naidol/jupitercpp_ws/docs/ESP32_S3_MCU_JUPITER_PINOUT.md

# ESP32-S3 MCU — Jupiter Pinout  ·  ⚠ MOVED

**This file is a stub. Do not edit it, and do not use it as a reference.**

The pin map was absorbed into **`NEW_MOTION_CONTROL_BOARD_2026.md` §3.1** on **2026-08-24**, which
is now the single source of truth for the 2026 board redesign — pin map, BNO086 breakout wiring,
power rails, connectors and BOM.

Two documents carrying the same pin map is exactly how they drifted apart: this file and §3.1
disagreed about GPIO4, GPIO9, the INA226 and the I²C bus for three days before it was caught.

**Go to:** [`NEW_MOTION_CONTROL_BOARD_2026.md`](NEW_MOTION_CONTROL_BOARD_2026.md) → §3.1

The full pre-merge content is preserved in git history (`git log --follow -- docs/ESP32_S3_MCU_JUPITER_PINOUT.md`).
