naidol/jupitercpp_ws/apriltags/tag36h11_id1_100mm_A4.pdf

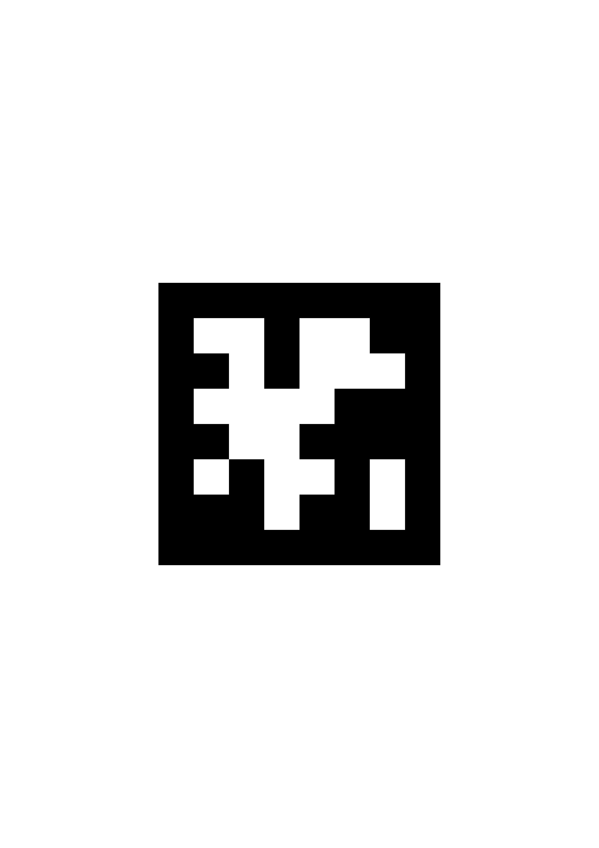
[picture p1: page 1]
