naidol/jupitercpp_ws/apriltags/tag36h11_id1_80mm_A4.pdf

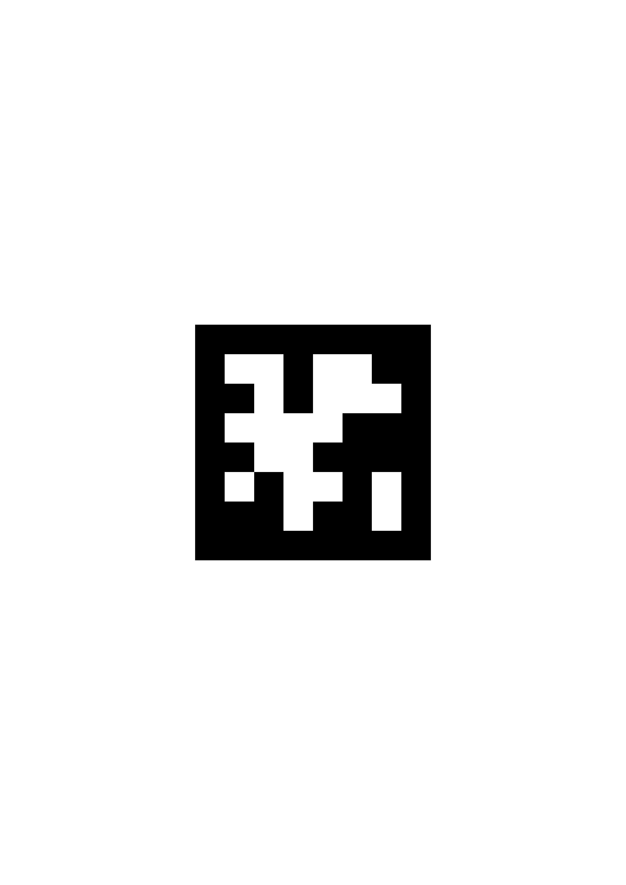
[picture p2: page 1]
