naidol/jupitercpp_ws/apriltags/tag36h11_id1_60mm_A4.pdf

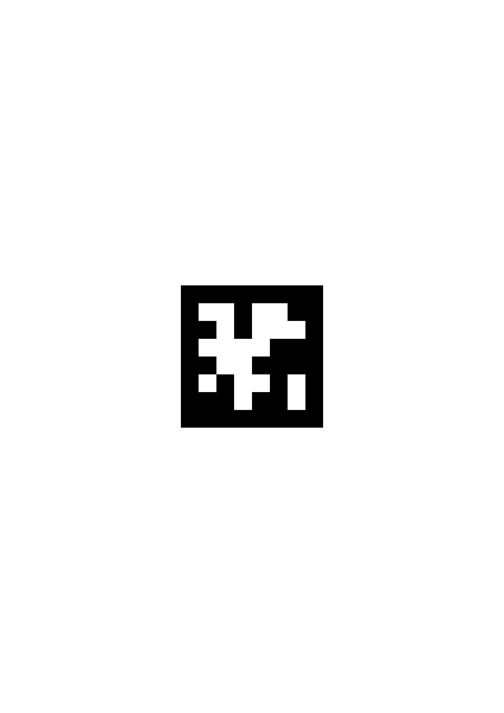
[picture p3: page 1]
