naidol/jupitercpp_ws/apriltags/tag36h11_id2_A4.png

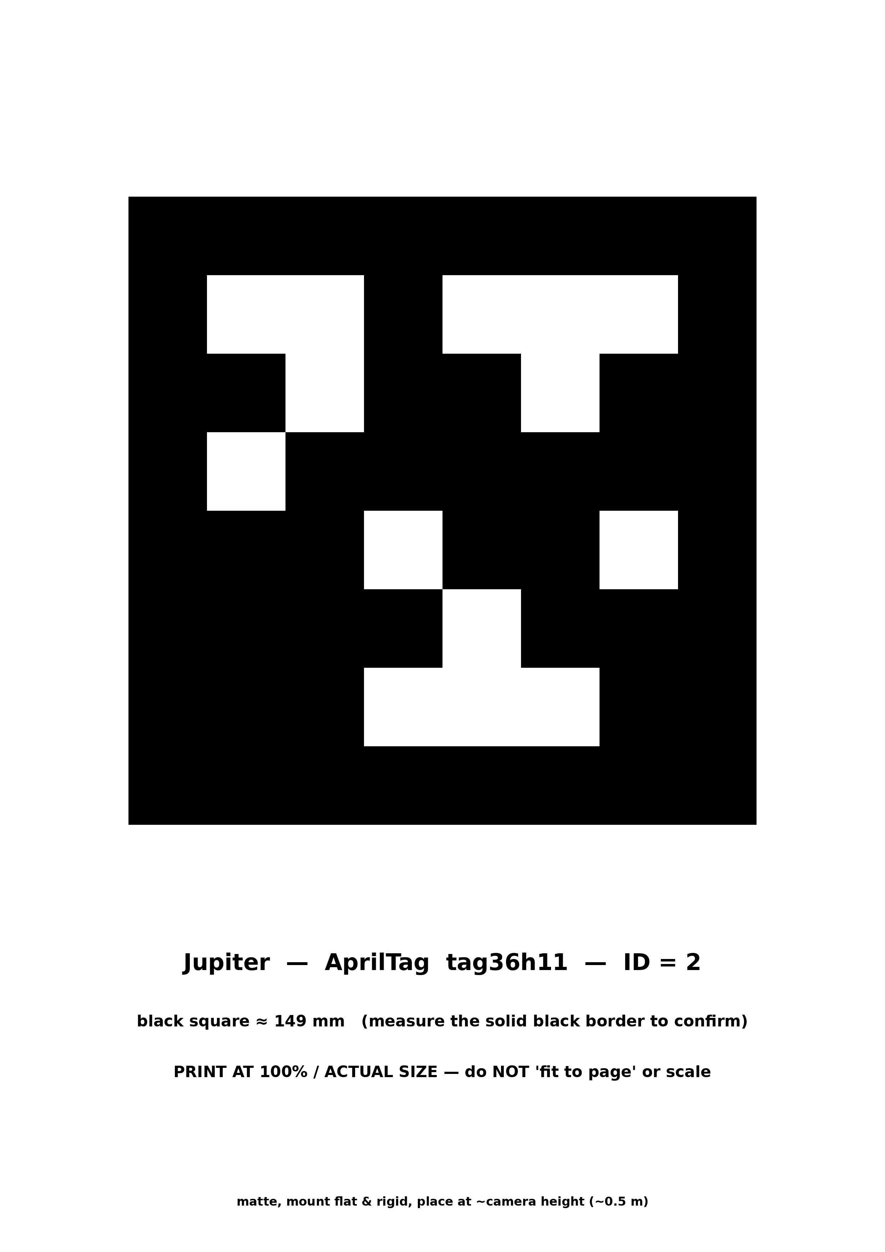
apriltags/tag36h11_id2_A4.png
