naidol/jupitercpp_ws/maps/_compare3.png

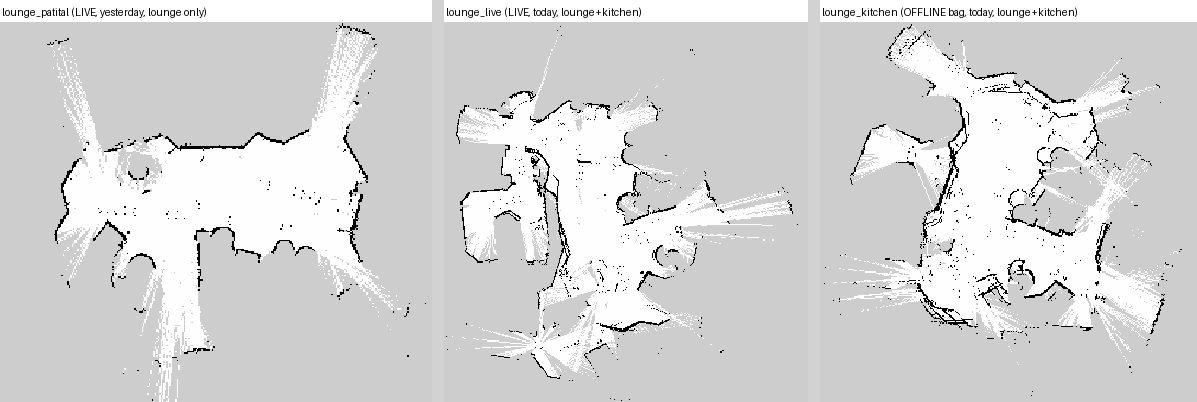
maps/_compare3.png
