naidol/jupitercpp_ws/maps/_deskew_compare.png

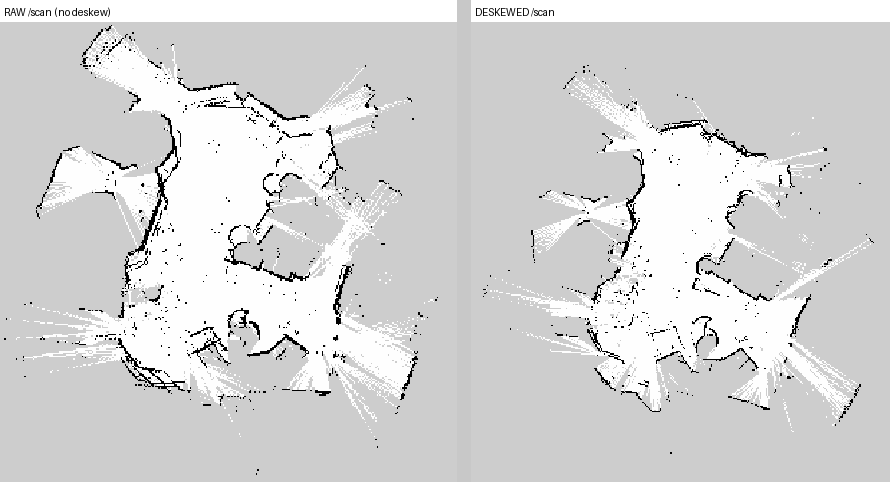
maps/_deskew_compare.png
