naidol/jupitercpp_ws/maps/apartment_s2e_v2_view.png

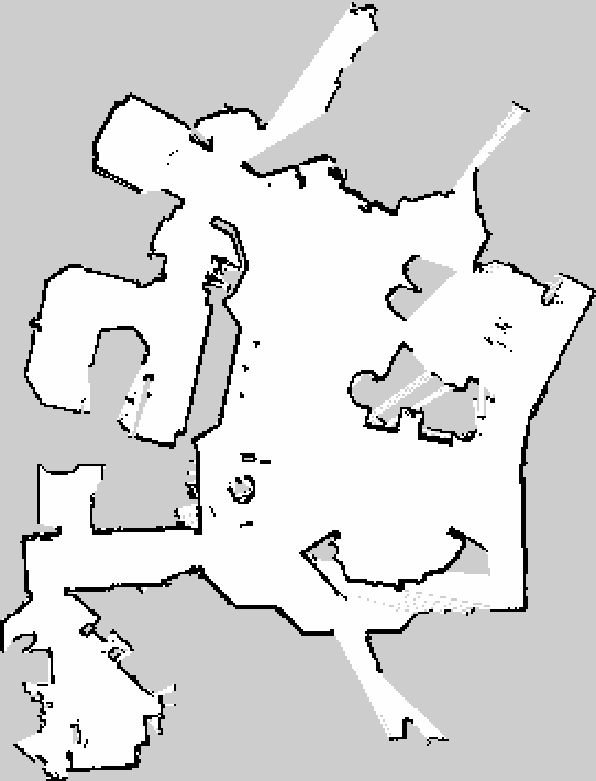
maps/apartment_s2e_v2_view.png
