naidol/jupitercpp_ws/maps/apartment_s2e_view.png

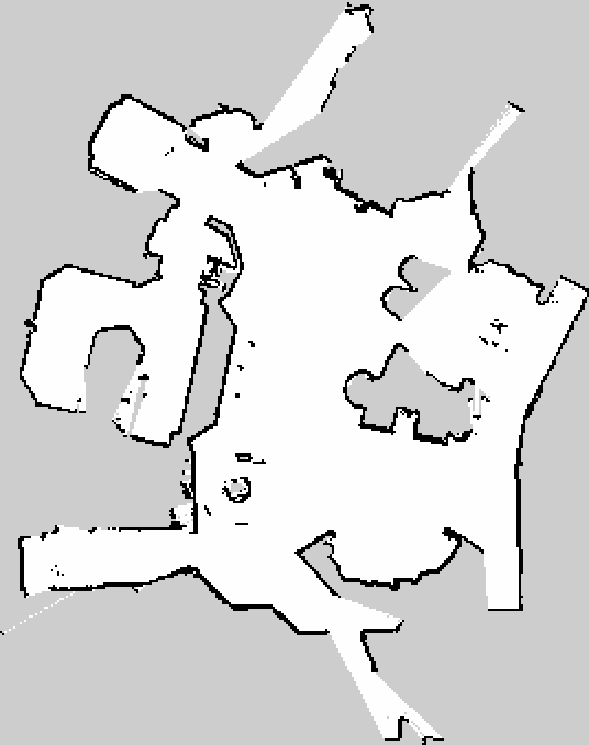
maps/apartment_s2e_view.png
