naidol/jupitercpp_ws/maps/apartment_view.png

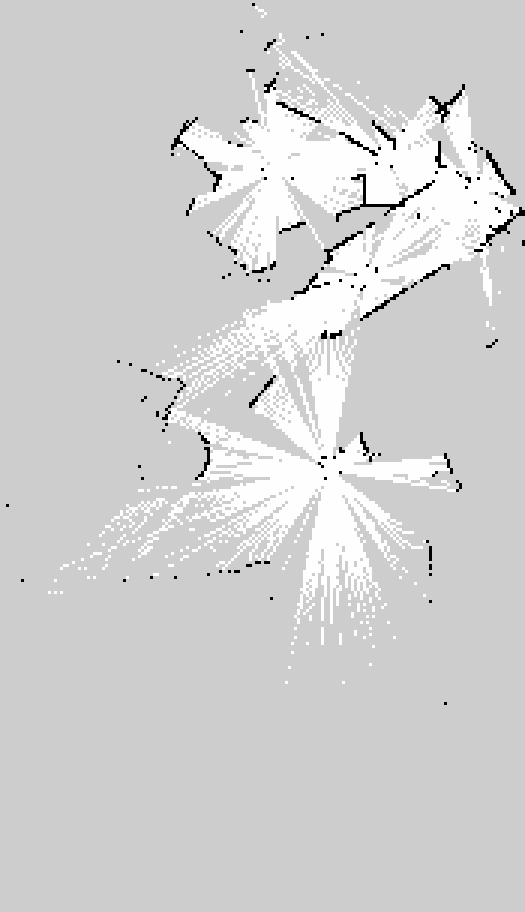
maps/apartment_view.png
