naidol/jupitercpp_ws/maps/lounge_kitchen_view.png

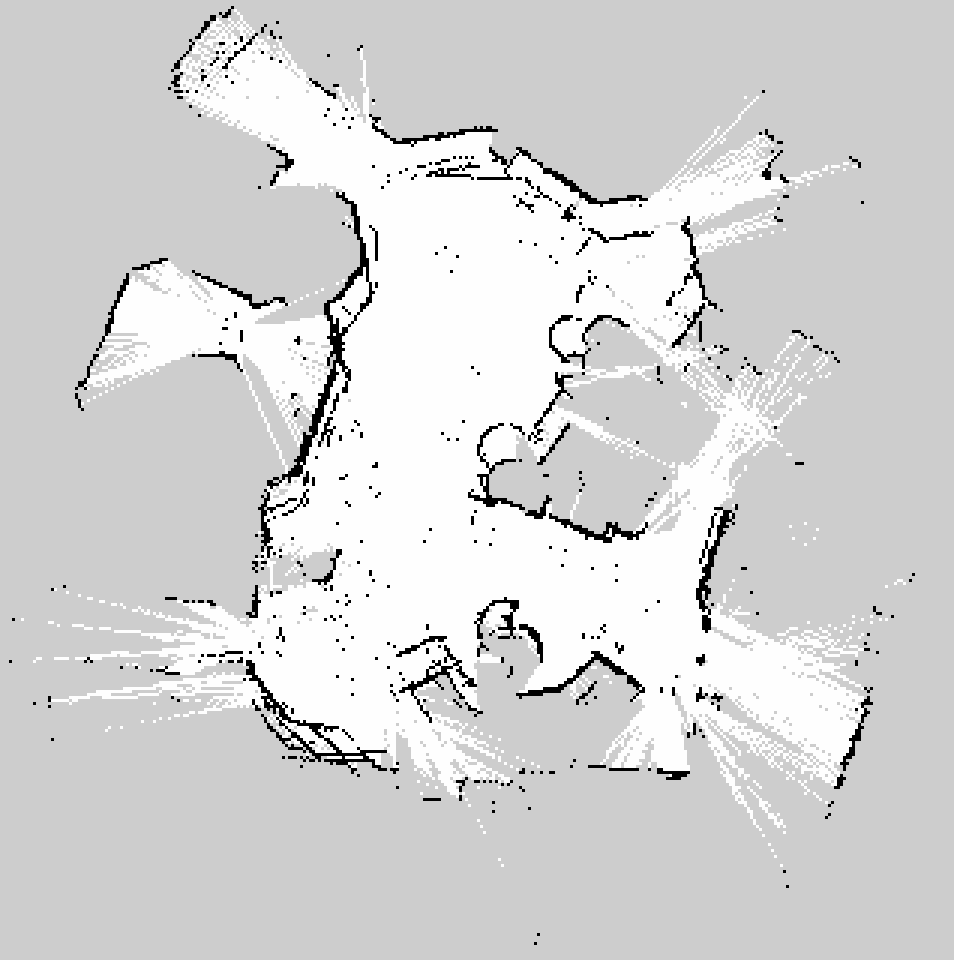
maps/lounge_kitchen_view.png
