naidol/jupitercpp_ws/maps/lounge_live_view.png

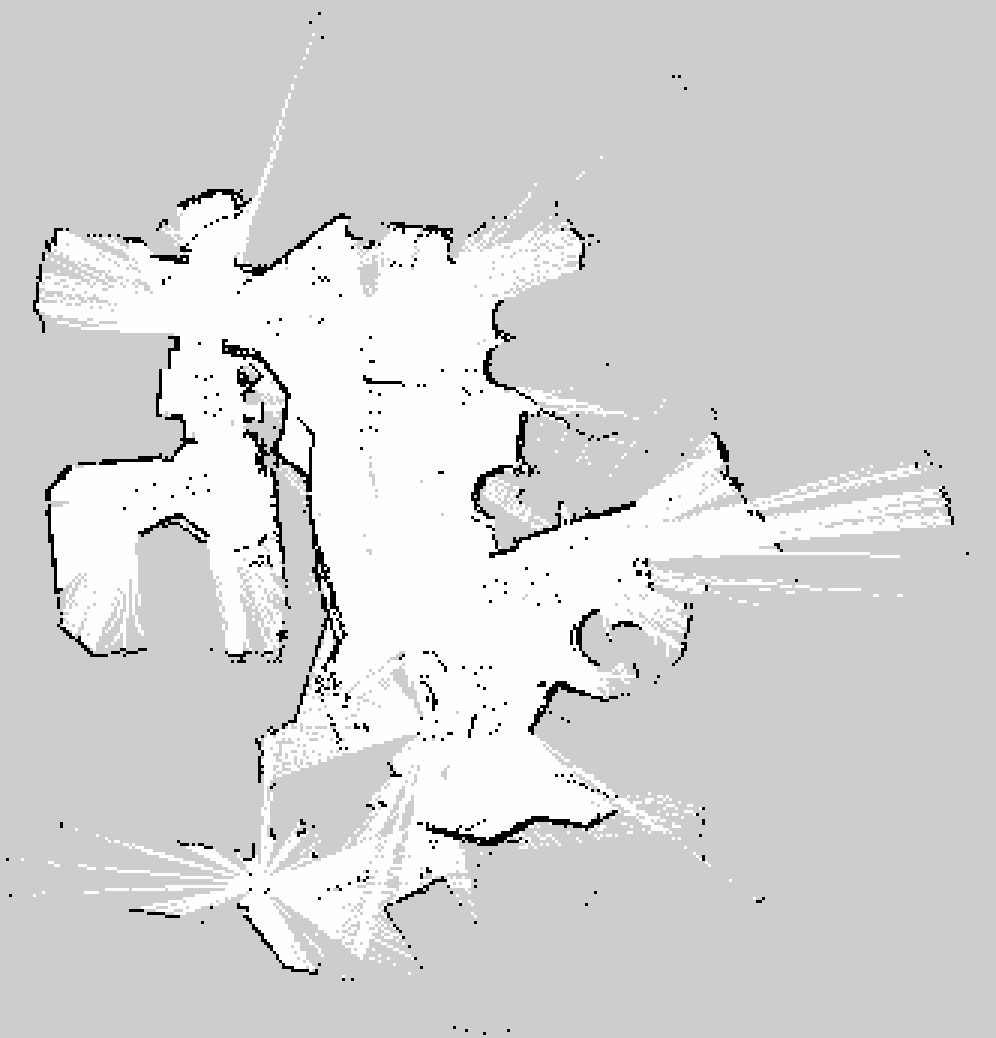
maps/lounge_live_view.png
