naidol/jupitercpp_ws/maps/lounge_patital_view.png

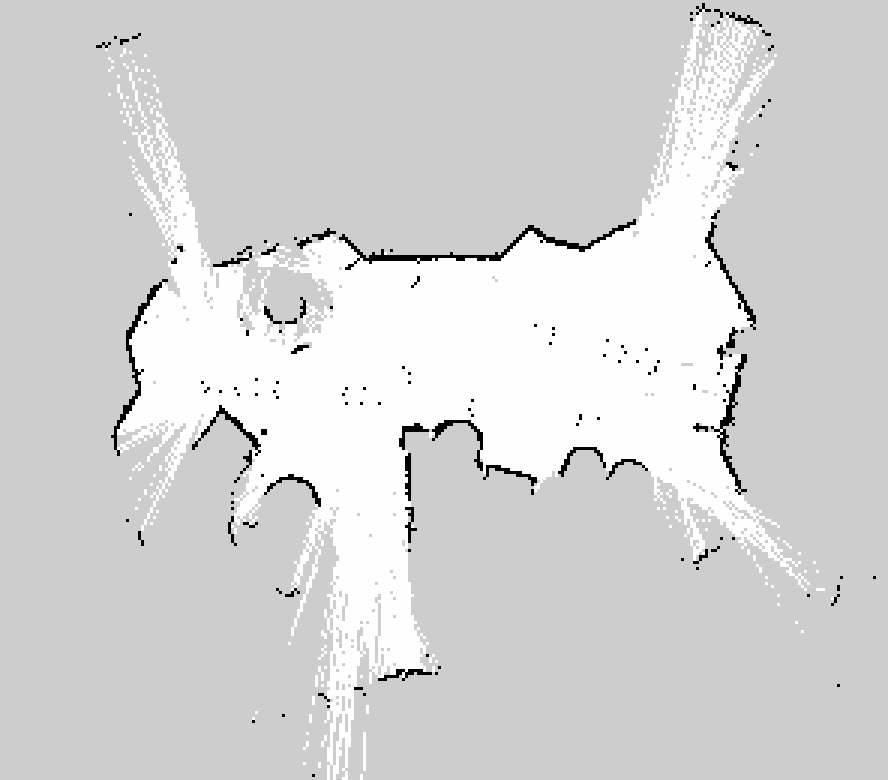
maps/lounge_patital_view.png
