naidol/jupitercpp_ws/hardware/dock_funnel/funnel_rail_left.stl

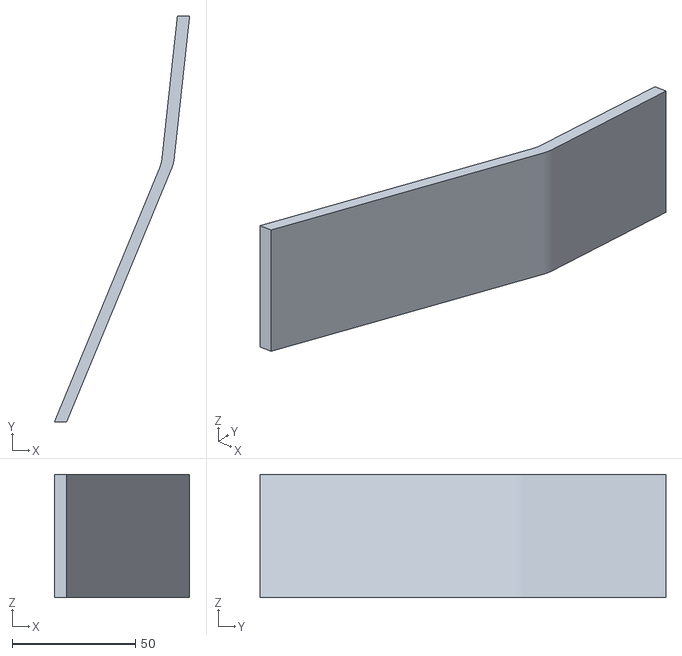
[picture p18: CAD file, 2026-08-01]
hardware/dock_funnel/funnel_rail_left.stl
55.0 x 165.0 x 50.0
