naidol/jupitercpp_ws/(list of files, cad)

Other CAD files:
hardware/dock_funnel/funnel_rail_profile.dxf
hardware/dock_funnel/funnel_rail_right.stl
