naidol/jupitercpp_ws/(commit log)

2026-05-04 Initial commit — Jupiter ROS2 workspace
    Packages:
    - jupiter_bringup: localization (EKF + BNO055), SLAM, Nav2 launch files and config
    - jupiter_nodes: imu_covariance_fixer, diagnostics, vision stubs
    - ldlidar_stl_ros2: LD19 driver (modified ld19.launch.py for Jupiter — base_footprint TF, /dev/jupiter_lidar port)
2026-05-05 Add master jupiter_bringup.launch.py
    Single launch entry point for the full robot stack:
    - micro-ROS agent (t=0s)
    - localization + SLAM or Nav2 (t=3s, mode:=slam default or mode:=nav)
    - LD19 LiDAR (t=6s, after TF tree is ready to avoid scan timestamp race)
    Voice and vision nodes stubbed as comments for future integration.
2026-05-05 Tune LiDAR range params for LD20 (8m indoor, 6Hz)
    slam_params: max_laser_range 12.0 -> 7.5m
    nav2_params: amcl laser_max_range 100.0 -> 8.0m
2026-05-05 Add CLAUDE.md with full project spec and current status
    Renamed from claude.md so Claude Code auto-loads it each session.
    Updated package structure, completed subsystems, and known issues
    to reflect current state of the build.
2026-05-06 Add jupiter_voice and jupiter_brain C++ ROS2 nodes
    - voice.cpp: ALSA capture (ReSpeaker plughw:2,0) → whisper.cpp GPU ASR
    → /voice/raw_text; /voice/response_text → piper TTS → speaker
    Handles USB full-duplex by closing/reopening ALSA handle around TTS;
    is_speaking_ flag blocks re-transcription during brain processing.
    - brain.cpp: /voice/raw_text → Ollama HTTP (gemma4:e2b, 100% GPU)
    → /voice/response_text; rolling 6-turn conversation history;
    current date/time injected per query; emoji stripped for clean TTS;
    handles thinking-model empty content field gracefully.
    - CMakeLists.txt: adds jupiter_voice (asound + whisper.cpp) and
    jupiter_brain (libcurl + nlohmann_json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
2026-05-06 Add face recognition, VLM vision, and per-user memory to Jupiter
    - face_recognition.cpp: YuNet (OpenCV CPU) + SFace (TensorRT CUDA) face
    recognition; profiles stored as JSON embeddings in memory/profiles/;
    publishes /current_user at 1Hz; supports /vision/register and /vision/trigger
    - brain.cpp: visual intent detection routes to llava:7b VLM with base64 JPEG;
    text queries use gemma4:e2b; per-user conversation history persisted to
    memory/conversations/<Name>.json; guest registration flow; user-aware greetings
    - CMakeLists.txt: add TensorRT (nvinfer, nvonnxparser), CUDA runtime, and
    nlohmann_json linkage for jupiter_face_recognition
    - jupiter_bringup.launch.py: add camera, voice, bra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
2026-05-07 Fix audio capture and face recognition guest detection
    - Replace ALSA capture with pw-record via fork/exec — PipeWire owns the
    ReSpeaker hardware after reboot making direct ALSA access unreliable;
    pw-record uses PipeWire natively matching pw-cat used for TTS playback
    - Remove asound library dependency from CMakeLists
    - Add clean Ctrl+C shutdown: destructor kills pw-record child PID before
    joining audio thread so exit is immediate rather than blocking 5s
    - Add response watchdog (30s) so voice node never gets permanently stuck
    if brain goes silent; deadline initialised to max() to prevent spurious
    firing on brain-initiated greetings
    - Lower energy_threshold to 300 (noise floor ~45,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
    [face_recognition.cpp, voice.cpp]
2026-05-08 Filter Whisper noise labels and raise SLAM bond timeout
    - Drop ASR results that are Whisper noise labels ([Barking], [Music],
    (applause), *beep* etc.) before publishing to brain — prevents ambient
    sounds like vacuum cleaners or fans from triggering LLM responses
    - Raise lifecycle_manager bond_timeout from 4s to 15s in slam.launch.py
    so SLAM toolbox has enough time to initialise under heavy GPU startup
    load (Whisper + TRT SFace + camera all loading simultaneously)
    [voice.cpp]
2026-05-09 Tune SLAM/voice load and add AI-only launch mode
    - Add enable_slam flag (default false) — voice/vision/brain/camera run
    without SLAM/LiDAR; enable_slam:=true brings up full navigation stack
    - Two camera configs: color-only MJPG in AI-only mode (avoids USB DMA
    contention with Whisper), color+depth in SLAM mode for Nav2 costmaps
    - slam_toolbox: minimum_time_interval 0.5→1.0 to halve Ceres CPU load
    - lifecycle_manager: bond_timeout 0.0 disables false bond-failure errors
    caused by Ceres initialization blocking heartbeats
    - Voice: energy_threshold 300→500 to filter ambient noise; record_seconds
    5→8 to reduce Whisper GPU inference frequency during SLAM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
2026-05-12 Update CLAUDE.md with completed firmware subsystems
    - ESP32 auto-reconnect state machine complete
    - ESP32 battery monitoring firmware complete (hardware wiring pending)
    - Remove resolved known issue (physical reset no longer needed)
2026-05-13 Reduce Whisper hallucinations with three filters
    1. no_speech_prob check: skip segments where Whisper's own no-speech
    probability exceeds 0.5 — catches ambient noise Whisper classifies
    as non-speech internally but still transcribes
    2. Minimum 2-word filter: single-word results (e.g. "you") are almost
    always hallucinations from background noise
    3. 500ms post-TTS silence buffer: prevents room echo from TTS playback
    being captured at the start of the next recording window
    [voice.cpp]
2026-05-13 Fix Whisper hallucination: remove robot prompt + add token confidence check
    The initial_prompt 'Jupiter is a home robot assistant' primed Whisper to
    generate robot/computer vocabulary from ambient noise (HVAC/fan hum),
    causing the same on-topic hallucination to repeat across sessions.
    Average token confidence < 0.40 now rejects the result — hallucinated text
    from background noise has characteristically lower token probabilities than
    genuine speech. Combined with the existing no_speech_prob and word-count
    filters, this should eliminate the repeating false transcriptions.
    [voice.cpp]
2026-05-16 Add temporal energy ratio VAD to eliminate Whisper GPU jitter
    Replace sherpa-onnx (ONNX Runtime CUDA conflict) with a zero-dependency
    VAD: splits each 8s capture into 100ms windows and skips Whisper when
    max/min RMS ratio < vad_snr_ratio (default 1.7). HVAC noise ratio ~1.1,
    speech ratio ~2-10. Also makes micro-ROS agent optional via
    enable_microros launch arg (default false).
    [voice.cpp]
2026-05-18 Add Jupiter Display node — Qt6 QML animated robot face on 7-inch panel
    - New package: jupiter_display (Qt6 + ROS2, pure C++)
    - DisplayBridge QObject exposes state/currentUser/batteryVoltage/speakingMs to QML
    - Subscribes: /current_user, /voice/raw_text, /voice/response_text, /battery/state
    - States: LISTENING (smile), PROCESSING (squint + dots), SPEAKING (open mouth animation)
    - C++ screen selection targets 1024x600 panel (DP-1); falls back to primary
    - Qt event loop exits cleanly on Ctrl+C via 200ms rclcpp::ok() poll timer
    - Added jupiter_display to bringup launch (2s delay, DISPLAY=:1)
2026-05-19 Fix brain LLM blocking spin thread and voice watchdog too short
    - brain: move LLM/VLM calls to background thread — spin loop stays
    responsive during Ollama inference; llm_busy_ atomic prevents
    overlapping requests
    - brain: max_tokens 2000 → 400 — 1-3 sentence responses don't need
    2000 tokens; cuts gemma4 response time from 45s to ~10s
    - brain: null-safe content extraction in http_post() — was throwing
    json::type_error when content field is null
    - voice: response_timeout_s default 30 → 90 — 30s fired before the
    LLM had time to respond, silently dropping every text answer
    [brain.cpp, voice.cpp]
2026-05-19 Fix spurious watchdog and LLM identity override by voice
    - voice: reset speak_deadline_ to max() after each TTS response —
    stale deadline from a prior query was causing the watchdog to fire
    3-4s into the next autonomous greeting (face recognition transition)
    - brain: instruct LLM that face recognition is the authoritative
    identity; prevents a voice claim of "I'm Indrani" from overriding
    face-confirmed "Logan", which was corrupting Logan's history file
    with another person's conversation
    [brain.cpp, voice.cpp]
2026-05-19 Fix VLM identity bridge, stale snapshot, VAD stuck loop, and clean shutdown
    brain.cpp:
    - Pass captured_user at query time to query_vlm/query_llm to avoid race
    where face recognition briefly returns Unknown during slow llava inference
    - Delete /tmp/jupiter_view.jpg before triggering snapshot and poll for fresh
    file (up to 2s) to prevent stale frames from previous sessions being used
    - Add gemma4:e2b identity bridge in query_vlm: llava:7b describes the scene,
    gemma4:e2b synthesises a one-sentence reply using the C++ face engine identity
    - Instruction-first bridge prompt layout so the 2B model follows format rules
    - Name-injection fallback: prepend "for_user, " if name absent from respons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
    [brain.cpp, face_recognition.cpp, voice.cpp]
2026-05-20 Fix Ctrl+C SIGKILL regression in voice and display nodes
    jupiter_voice: blocking waitpid() in capture_chunk() and speak() shutdown
    paths caused the audio thread to hang indefinitely after SIGINT. Linux
    SA_RESTART (set by rclcpp's signal handler) causes interrupted syscalls to
    restart automatically, so a blocking waitpid() after SIGTERM never returned.
    Fix: use SIGKILL in the shutdown path so waitpid() returns in microseconds.
    The normal end-of-chunk deadline path uses a WNOHANG poll loop instead.
    jupiter_display: ros_thread was detached, allowing it to outlive main()'s
    return and use rclcpp/DDS objects after their destructors fired — causing a
    hang during process cleanup. Fix: capture n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
    [voice.cpp]
2026-05-20 Add system status HUD to display and fix micro-ROS launch delay
    Display node now subscribes to /camera/color/camera_info, /scan, and
    /cmd_vel to track sensor health, and polls sysfs every 2s for CPU/GPU
    temperatures and WiFi signal strength.
    JupiterFace.qml gains a top bar (mode indicator + velocity + WiFi %)
    and an expanded bottom bar with CAM/LIDAR/VOICE health dots, CPU/GPU
    temperature readouts, and a visual battery bar with % and voltage.
    Sensor dots blink red when offline; temps colour-shift orange >70°C
    and red >85°C; battery bar colours by charge level.
    micro-ROS agent launch delay reduced from 70s to 10s now that the
    ESP32 serial adapter is on USB-C Bus 001, fully isolated from O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
2026-05-20 Ignore sherpa-onnx binaries and model archives
    sherpa-onnx/ and sherpa-onnx-kws-zipformer-gigaspeech-3.3M-2024-01-01/
    are downloaded prebuilt binaries and ONNX models — too large for git
    and not source code. Added matching .tar.bz2 glob as well.
2026-05-20 Fix SPEAKING→LISTENING lag with exact TTS-done signal
    Replace the word-count timer estimate in the display node with a
    precise /voice/tts_done (std_msgs/Empty) signal published by the
    voice node immediately after TTS playback finishes and the 500ms
    room-echo pause elapses.
    Display now transitions from SPEAKING to LISTENING at the exact
    moment audio stops rather than after a ~1s overestimate. Removes
    speakingMs property and QML Timer entirely — no estimate needed.
    [voice.cpp]
2026-05-21 Add LiDAR watchdog to auto-recover from Whisper-induced frame sync loss
    Whisper GPU inference causes tegra-xusb DMA stalls that overflow the LD19
    cp210x serial FIFO, breaking SDK frame sync. The ldlidar SDK has no built-in
    recovery — once frame sync is lost, it emits timeout errors indefinitely.
    The watchdog (lidar_watchdog.sh) monitors /scan and restarts
    ldlidar_stl_ros2_node within ~10s of detecting a timeout. The static TF
    publisher (base_footprint→base_laser) is split out to run independently so
    the transform is never interrupted during LiDAR restarts.
    Also carries forward: depth disabled in SLAM camera config (90s→38s init),
    LiDAR delayed to 30s (was 6s), micro-ROS agent kept at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
2026-05-21 Reduce micro-ROS startup delay from 70s to 15s
    Camera now initialises in ~3s after ReSpeaker was isolated onto a
    separate hub branch, so the original 70s (set when camera took ~38s)
    is no longer needed. 15s gives comfortable margin after camera (~7s)
    and AI nodes (~10s) are fully settled.
2026-05-21 Fix conversation history reset on bringup restart
    Non-atomic writes to the JSON history file were being corrupted by
    Ctrl+C landing between file truncation and write completion, causing
    json::parse to throw on next load and silently clear history.
    Fixed with atomic write-then-rename (rename(2) is a single kernel
    syscall). Also added an explicit save in the destructor so clean
    shutdown always flushes the last exchange before exit.
    [brain.cpp]
2026-05-21 Add sleep face to display and fix wake-on-face-detect bug
    Brain publishes /jupiter/sleeping (std_msgs/Bool) on sleep/wake.
    Display subscribes and drives three visual changes:
    - Eyes close slowly to a thin slit (yScale 0.06) over 800ms
    - Mouth shows a flat neutral line instead of a smile
    - Status bar shows 'SLEEPING' in dim colour
    Also fixes user_callback triggering greet_user while sleeping —
    face re-detection in sleep mode now silently updates user tracking
    without speaking.
    [brain.cpp]
2026-05-21 Fix guest name extraction and registration flow bugs
    - extract_name() strips natural-speech preambles ("my name is", "I am",
    etc.) so any conversational reply yields the correct first name
    - Word-boundary check on "no" prevents false declines from words like
    "know", "noel", or "normal"
    - Set current_user_ before speaking "Done!" to prevent user_callback
    double-greeting on the next 1Hz face-recognition tick
    [brain.cpp]
2026-05-22 Fix sleep/wake stuck bug and tune VAD for ReSpeaker
    - brain.cpp: publish empty ack when sleeping and input is not a wake
    phrase, so voice.cpp clears is_speaking_ immediately instead of
    waiting out the 90s response timeout
    - voice.cpp: response_callback clears is_speaking_ on empty response
    (silent ack) rather than returning without resetting state
    - bringup: lower energy_threshold 500→300 for ReSpeaker with on-chip
    noise suppression (silence RMS ~12, well below 300)
    - face_recognition: add per-match similarity logging to aid threshold
    tuning; Guest logs closest-miss score
    - display_node: hide window before app.quit() on shutdown (partial fix,
    parked — framebuffer still retain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
    [brain.cpp, face_recognition.cpp, voice.cpp]
2026-05-25 Fix SLAM: resolve heading misalignment, odom drift, and starburst
    Three root causes diagnosed and fixed:
    1. imu0_differential: true — BNO055 reports absolute yaw relative to
    magnetic north, not robot forward direction. With differential=false,
    the odom/map frames started 90° off from the robot's physical heading,
    placing every scan node at the wrong orientation and making scan
    matching fail. Using yaw changes instead of absolute yaw fixes alignment.
    2. odom0_relative: true — ESP32 odometry counters accumulate across
    micro-ROS reconnects without resetting. Each new ROS session inherited
    the previous session's accumulated position, displacing the map origin.
    Relativ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
2026-05-25 Enable camera during SLAM mapping for remote RViz visual feedback
    Camera was gated behind enable_voice, but the DMA stall issue was caused
    by Whisper GPU inference, not the camera stream. Color-only MJPG 640x480
    @ 15fps is low USB bandwidth and does not affect LiDAR serial throughput.
    Decoupling camera from voice lets the operator see a live image feed in
    RViz2 while manually mapping, reducing collision risk during remote teleop
    over WiFi without relying on laser scan alone.
2026-05-25 Replace AMCL+EKF with Isaac ROS cuVSLAM for navigation localisation
    Install Isaac ROS 4.4.0 native apt packages (no Docker): cuVSLAM,
    occupancy_grid_localizer, AprilTag, nvblox core. cuVSLAM publishes
    the full map→odom→base_footprint TF chain from Orbbec 336 depth+IMU,
    eliminating AMCL drift and EKF dead-reckoning dependency.
    - visual_slam.launch.py: cuVSLAM node (RGBD+IMU mode), camera TF
    base_footprint→camera_link at (0.10, 0.0, 0.49m)
    - navigation.launch.py: remove AMCL+EKF, include visual_slam launch
    - jupiter_bringup.launch.py: split slam/nav camera modes; nav mode
    enables depth 640×480@30fps + accel/gyro 200hz sync output
    - nav2_params.yaml: odom_topic → /visual_slam/trac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
2026-05-25 Fix cuVSLAM: IMU fusion, correct topics, jitter threshold; add maps and new packages
    cuVSLAM fixes (confirmed working — map→odom→base_footprint at 28 Hz):
    - Raise image_jitter_threshold_ms 40→100ms: Orbbec delivers at ~66ms/15fps,
    40ms threshold caused cuVSLAM to reject every frame and never publish odom TF
    - Fix imu_frame: camera_gyro_optical_frame → camera_accel_gyro_optical_frame
    (confirmed from live topic echo of /camera/gyro_accel/sample)
    - Fix depth remapping: /camera/depth_to_color/image_raw → /camera/depth/image_raw
    (Orbbec SDK 2.7.6 with align_mode=SW publishes on depth, not depth_to_color)
    - Fix IMU remapping: /camera/imu → /camera/gyro_accel/sample
    - Explicitly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
2026-05-25 Replace LiDAR with vision-only nav: cuVSLAM + nvblox + Nav2 MPPI
    - Remove LiDAR entirely (LD19 static TF, watchdog script, all LiDAR
    costmap layers) — tegra-xusb DMA contention made it unworkable
    - Add nvblox.launch.py: GPU TSDF reconstruction from Orbbec depth
    → 2D ESDF slice for Nav2 NvbloxCostmapLayer
    - Rewrite navigation.launch.py: map_server removed, nvblox added,
    cuVSLAM provides localisation (no pre-built map required)
    - Rewrite slam.launch.py: pure cuVSLAM visual-map-building mode,
    slam_toolbox and EKF removed
    - nav2_params.yaml: replace all LaserScan/VoxelLayer config with
    NvbloxCostmapLayer; add global costmap bounds (40x40m);
    add transform_tolerance:0.5 for cuVSLAM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
2026-05-27 Fix vision-only nav: passive IR stereo, safe mecanum recovery, confirmed 3m nav
    - cuVSLAM: switch to passive IR stereo (projector OFF) — projector dot pattern
    moves with camera and causes tracking drift; ambient IR tracks room-fixed features
    - cuVSLAM: correct optical frame IDs to camera_left/right_ir_optical_frame
    - cuVSLAM: camera pitch 0 (level) — upward tilt reduces wall features in FOV
    - Nav2: remove Spin+BackUp recovery behaviors — unsafe on mecanum (caused bar stool
    collision); replace with costmap clear + Wait in custom BT XMLs
    - Nav2: add navigate_to_pose_omni.xml and navigate_through_poses_omni.xml
    - Nav2: add decay_time to ObstacleLayer to prevent goal cell burial in sta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
    [brain.cpp]
2026-05-29 Fix nav stack: LiDAR yaw, lifecycle timeout, inflation tuning
    - Revert base_laser yaw to 0 (LiDAR physically rotated back to correct orientation)
    - Disable cuVSLAM map→odom; replace with static identity TF (bad VIO transform
    was lifting costmaps off floor and corrupting base_footprint orientation)
    - Delay lifecycle_manager 5s + bond_timeout=0 to fix MPPI CUDA init timeout
    that left planner_server and bt_navigator unconfigured at startup
    - Increase inflation_radius 0.20→0.30 in both costmaps and MPPI ObstaclesCritic
    - Increase ObstaclesCritic repulsion_weight 1.0→3.0, critical_weight 10.0→20.0,
    collision_margin_distance 0.10→0.15 for better wall avoidance in narrow passage
    - N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
2026-05-29 Add jupiter_bringup_full.launch.py — unified full-stack launch
    Single Orbbec camera instance serving all subsystems simultaneously:
    - Left/Right IR stereo @ 15fps for cuVSLAM
    - Color MJPG 640x480 @ 15fps for face recognition
    - IMU 200Hz for EKF
    - Laser projector OFF (mandatory for passive IR cuVSLAM tracking)
    - Depth disabled (saves DMA bandwidth)
    Fixes camera conflict where nav-only and voice-only bringups both
    tried to open the Orbbec independently, causing uvc_open -6 errors
    and system slowdown/reboot.
    Startup sequence timed to avoid USB DMA contention:
    t=0s display, t=2s micro-ROS, t=3s nav stack,
    t=5s camera, t=7s voice+brain, t=8s face recog+vision
    Usage: ros2 launch jupiter_bring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
2026-05-29 Fix full bringup: add LaunchConfiguration import, reduce color fps
    - Add missing LaunchConfiguration import (caused launch error)
    - Reduce color stream from 15fps to 6fps to prevent LiDAR USB DMA
    starvation — IR stereo + color + IMU at 15fps saturated tegra-xusb
    causing LD20 serial timeout errors
2026-05-30 Fix full bringup: add LaunchConfiguration import, reduce color fps
    - Redesign bringup startup sequence for blitsvinnig AI-only mode:
    t=0s display + screensaver/DPMS disabled
    t=1s camera (color+depth+IMU) — depth required to avoid 20s SDK timeout
    t=2s voice/Whisper — ready before first face match to avoid greeting race
    t=3s face recognition, vision, brain
    - Fix Orbbec SDK 20s color-only timeout: enable depth 424x240@6fps as dummy
    stream (nobody subscribes) — forces fast SDK init path (~235ms vs 22s)
    - Fix greeting race condition: Voice was starting at t=8s, brain published
    greeting at t=5s, display stuck on speaking icon forever — moved Voice to t=2s
    - Fix ASR stuck af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
    [voice.cpp]
2026-05-30 Add camera.launch.py — persistent camera process for fast bringup
    Split camera into its own persistent launch file (camera.launch.py).
    Running camera separately and never killing it keeps Orbbec firmware
    warm, reducing startup from 55-65s to 14s to first greeting.
    Camera streams: color 640x480@15fps + left/right IR@15fps + IMU 100Hz
    All streams always on — nav and AI both served from one camera instance.
    Add enable_camera:=false arg to bringup (default false — assumes
    camera.launch.py is already running). Prevents camera conflict errors
    (uvc_open -6) when two processes try to open the same device.
    Change enable_microros default to true — should always start.
    Usage:
    Terminal 1 (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
2026-05-30 Update jupiter_bringup_full: include camera.launch.py as first action
    Full bringup now starts camera.launch.py internally — no separate
    terminal needed. Camera starts at t=0s with all streams (color + IR
    stereo + IMU), then nav stack at t=3s, voice at t=4s, AI at t=5s.
2026-05-30 Add startup_strategy.md — bringup sequence reference
    Documents startup constraints, timings and known issues for all modes.
2026-06-01 Add Pi5 audio offload + guest registration with name confirmation
    Moves the ReSpeaker XVF3800 off the Jetson Thor's USB bus to a Raspberry Pi 5
    sub-node, resolving both the USB/DMA contention and the capture wedge (mic
    stalling to silence under the old pw-record fork/kill cycling on tegra-xusb).
    - jupiter_audio_capture (NEW, runs on Pi5): continuous single-stream ALSA capture
    from the ReSpeaker, publishes /audio/mic_raw (Int16MultiArray, Best-Effort QoS,
    16kHz mono, 100ms frames). COLCON_IGNORE so the Thor does not build it.
    - voice.cpp: replace pw-record fork/kill with a /audio/mic_raw subscriber feeding
    a window accumulator; all prior logic intact (energy gate, temporal VAD,
    Whisp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
    [brain.cpp, voice.cpp]
2026-06-02 Add TTS caption to display — show Jupiter's spoken text on the 7-inch panel
    Renders bridge.lastResponse (already published from /voice/response_text) as a
    word-wrapped caption band above the bottom status bar. Border glows blue while
    speaking, dims otherwise; the caption persists through the LISTENING window so a
    guest can read the name spelling and the yes/no prompt while answering — directly
    improving the guest-registration flow.
    QML-only change; the C++ DisplayBridge already plumbed lastResponse.
2026-06-04 Fix SFace preprocessing — restore face discrimination (false-match bug)
    Different people were scoring 0.90+ against each other (e.g. wife matched as
    Logan), so a new person never fell through to "Guest" and registration never
    triggered. Root cause: the embedding preprocessing didn't match the OpenCV Zoo
    SFace model (face_recognition_sface_2021dec). The code fed RGB + [-1,1]-normalised
    input; OpenCV's FaceRecognizerSF feeds raw BGR 0-255 (cv::dnn::blobFromImage
    defaults: scale=1.0, mean=0, swapRB=false). The mismatch collapsed the embedding
    space — same person still self-matched (consistent wrong transform) but inter-person
    similarity inflated to 0.9+.
    - face_recognition.cpp: feed raw BG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
    [face_recognition.cpp]
2026-06-04 Add "my name is …" guide phrase to registration prompts
    Steer new users to a carrier phrase at all three name-prompt points
    (Guest greeting, register-command, and the re-prompt after a miss).
    Whisper transcribes "my name is Logan" far more reliably than a bare
    name, and extract_name already strips the "my name is " prefix — so
    the guide costs nothing and parses straight to the name. The yes/no
    confirm gate still guards mishears; this just makes it trip less often.
    Hardware-validated: "My name is Logan" caught first try, no retry loop;
    fresh face scored 0.13-0.24 vs Indrani (Guest), registered cleanly.
2026-06-05 Add reliable LiDAR+wheel+IMU SLAM mapping (slam_toolbox); retire cuVSLAM for mapping
    cuVSLAM failed to track even a 2.5m drive in ideal conditions (bright, cluttered
    lab, full 15fps): wheel odometry measured 2.5m while cuVSLAM reported 4cm, zero
    landmarks. It was already benched for nav (publish_map_to_odom_tf: false) back in
    May for the same unreliability. So mapping moves to slam_toolbox on the parts of
    Jupiter that are solid.
    New slam_mapping.launch.py — vision-free, light-independent, USB-light:
    ESP32 wheel odom (/odom/unfiltered) + BNO055 yaw-rate (imu_covariance_fixer
    -> /imu/data/corrected) -> EKF -> odom->base_footprint
    LD20 LiDAR -> /scan
    slam_toolbox async -> map->odom +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
2026-06-07 Add scan_deskew_node: motion-compensate LD20 sweep to fix rotational SLAM haze
    Root cause (measured, not assumed): the LD20 builds one 360 deg sweep over
    scan_time ~166 ms (6 Hz), but slam_toolbox stamps all ~667 rays at a single
    instant. During a turn the robot rotates ~5 deg across that sweep (~0.44 m smear
    at 5 m) -> the "hazy/double-wall" maps on rotation. Transport latency was ruled
    out by bag analysis: the LD20 is a Silicon Labs CP2102 (not FTDI) and the
    driver->consumer offset measured ~0.1 ms, not the 16 ms FTDI buffering myth.
    Odometry + heading were also proven good through rotation (spin tests), so the
    fault is purely scan-side. The driver populates time_increment (~249 us/ray),
    s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
    [scan_deskew_node.cpp]
2026-06-09 Vendor sllidar_ros2 (Slamtec ROS2 driver) for the RPLIDAR S2E
    Ethernet/UDP lidar driver cloned from Slamtec/sllidar_ros2, vendored flat
    (nested clone .git removed) to match the ldlidar_stl_ros2 convention. Provides
    sllidar_s2e_launch.py and the sllidar_node consumed by slam_mapping_s2e.
2026-06-09 Add RPLIDAR S2E SLAM mapping (slam_mapping_s2e.launch.py)
    Replaces the LD20 (USB/serial) with the RPLIDAR S2E (Ethernet/UDP) in the
    mapping chain; same proven micro-ROS + EKF + slam_toolbox pipeline, just the
    sllidar_node in place of ldlidar_stl_ros2_node (publishes /scan, frame base_laser).
    - Measured static TF base_footprint->base_laser: x=0.035, y=0, z=0.515, YAW=pi.
    The S2E sits on a riser above the Orbbec for a clean 360 deg view; its 0 deg is
    mounted facing BACKWARD, so base_laser is rotated 180 deg about z (verified in RViz).
    - slam_params.yaml max_laser_range 7.5 -> 18 m to exploit the S2E's reach down
    hallways (LD20 path unaffected; it caps ~8 m anyway).
    VALIDATED ON HARDWAR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
2026-06-10 Integrate Orbbec/nvblox 3D obstacles into the S2E Nav2 stack
    The RPLIDAR S2E sits at 0.515 m and is blind below its scan plane — it
    cannot see chairs, table legs, feet, the low things nav must avoid. Add the
    Orbbec 336 depth via nvblox as a second costmap obstacle source so Nav2 sees
    the low furniture the lidar misses (Gemini-advised hybrid 2D/3D perception).
    - nav2_params.yaml: add nvblox_layer (nvblox::nav2::NvbloxCostmapLayer,
    topic /nvblox_node/static_map_slice) to BOTH local + global costmaps,
    between obstacle_layer and inflation_layer. Also carries the prior nav
    config now validated: static_layer in the global costmap (planner needs the
    map), MPPI DiffDrive (vx+wz, no strafe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
2026-06-10 Tune S2E+nvblox Nav2: fix AMCL drift, doorway inflation, nvblox phantom accumulation
    Battery drive-testing the apartment nav stack surfaced three issues, all fixed and
    hardware-validated (lab -> through the doorway -> lounge, couch avoided):
    - AMCL ran open-loop on odometry between corrections: update_min_d 0.2 / update_min_a
    0.15 meant scan-matching only every 0.2 m / 0.15 rad. During the sub-0.2 m doorway
    approach the pose dead-reckoned on drifting wheel odom -> the scan slid right off the
    map and the robot clipped the jamb. update_min_d 0.2->0.05, update_min_a 0.15->0.1
    (clean 10 Hz S2E scan makes frequent corrections cheap). Robot now threads the doorway.
    - inflation_radius 0.4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
2026-06-11 Match Orbbec by serial only; document Thor USB layout + cold-boot fix
    The Orbbec was pinned by physical USB port (usb_port:'2-1') in the camera
    launches, so moving it to another port broke camera bring-up. Drop the port
    pin everywhere and match by serial_number (CP9KB53000HP) alone — unique to
    the one camera and immune to re-cabling. Validated: camera connects by serial.
    - camera.launch.py, camera_ai.launch.py, navigation_s2e.launch.py,
    jupiter_bringup.launch.py: usb_port '2-1' -> '' (serial-only match).
    - docs/THOR_USB_DMA.md: authoritative Thor USB/DMA topology reference. Records
    the 2026-06-11 re-cable (Orbbec USB-C 2-1 -> USB-A 10G hub 2-3.1) that fixed
    the cold-boot enumeration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
2026-06-12 nav: RPP + SmacPlanner2D stack, fix nvblox floor-marking (full doorway nav)
    Switch local controller MPPI -> Regulated Pure Pursuit and global planner
    NavFn -> SmacPlanner2D for the structured apartment; nvblox in both costmaps;
    inflation 0.55 / cost_scaling 5.0.
    Key bugfix: nvblox ESDF slice used non-existent param names
    (esdf_2d_min_height / esdf_2d_max_height) -> silently ignored -> nvblox
    sliced from the floor (0.0 m) -> the floor was baked into the costmap as
    obstacles -> "collision ahead" lock-up in any cluttered room. Renamed to
    esdf_slice_min_height: 0.10 / esdf_slice_max_height: 1.80 (verified against
    the installed nvblox source, esdf_integrator_params.h).
    RPP tune: lookahead_time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
2026-06-14 docking: bespoke AprilTag visual-approach node (dock_approach)
    Replace the abandoned opennav_docking attempt with a small, transparent
    proportional-control node. opennav's SimpleChargingDock never aligned (opaque
    external_detection frame conventions) and caused a backward runaway; a ~120-line
    P-loop does the job and we own the math.
    dock_approach.cpp: subscribes /vision/marker_pose, transforms the tag into
    base_footprint via tf2, turns to face + creeps forward, stops at target_distance
    (base_footprint->tag, default 0.40 m) and HOLDS — publishes zero every tick when
    idle, because the ESP32 has no cmd_vel watchdog and a single stop msg was being
    lost, leaving the robot creeping on a stale c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
    [dock_approach.cpp, vision.cpp]
2026-06-14 docking: holonomic square-up + graceful close-range stop
    Upgrade dock_approach from straight-line pursuit to a full square-up that ends
    perpendicular and centred on the tag, using Jupiter's mecanum strafe (kept for
    docking):
    - from the tag ORIENTATION take its outward normal; aim for an approach point
    target_distance out along that normal (directly in front of the tag).
    - holonomic servo: vx + vy(strafe) + wz drive the three errors (forward,
    lateral, heading) to zero independently -- no curved path, no singularity,
    the tag stays centred in frame.
    - graceful stop: the tag often drops out in the last few cm (it fills the
    frame); if lost within docked_on_loss_rho of the goal, cou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
    [dock_approach.cpp]
2026-06-14 full stack: "go to the dock" voice command + combined S2E launch
    Voice-commanded docking + the full VOICE|VISION|AI|NAV coexistence rig.
    brain.cpp: is_dock_phrase() ("go to the dock" / "dock yourself" / "go charge"
    ...) -> publishes /dock/engage (Bool) and says "Heading to the dock."
    dock_approach.cpp: also subscribes /dock/engage (mirrors the service) so the
    brain can engage docking. CMakeLists: add std_msgs to dock_approach deps.
    navigation_s2e.launch.py: parameterize color_width/height (default 640x480 =
    unchanged standalone) so the full stack can run the camera at 1280x720 for the
    AprilTag detector while nvblox keeps depth@640.
    jupiter_full_s2e.launch.py: NEW combined launch (current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
2026-06-24 nav: dual-IMU EKF + LD20 low-obstacle layer + RPP tuning → straight-line drive
    EKF heading (ekf_odom.yaml):
    - BNO055 absolute yaw orientation fused (imu0_relative: false) — magnetometer anchor
    - Orbbec internal gyro added as imu1 at 197Hz (yaw rate only) — bridges 6Hz BNO055 gaps
    - Yaw process noise 0.06→0.01, vyaw 0.02→0.005 — trust integrated heading between corrections
    - Result: stationary angular.z noise <0.002 rad/s; confirmed straight-line drive
    Obstacle sensing (nav2_params.yaml + navigation_s2e.launch.py):
    - nvblox RETIRED: camera tilted 5.7° up for face-rec makes floor depth unreliable
    - LD20 lidar added as scan_low observation source at 0.13m (catches chair legs/feet)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
    [brain.cpp]
2026-06-25 docking: guide fins + target_distance 0.28->0.22 -> pogo pin contact confirmed
    Physical V-guide fins printed and mounted on dock station. Extended entry ramps
    added to smooth wheel guidance into the slot. Result: bearing -2.4deg, lateral
    0.000m, consistent pogo pin contact. Reduced target_distance from 0.28 to 0.22m
    to seat pins reliably.
2026-06-27 docking: bearing-only DRIVE-IN + solvePnP flip rejection + stiction fix
    - DRIVE-IN now uses wz only (bearing-only correction, cap 0.05 rad/s) —
    fixed lateral_bias caused rotational coupling on mecanum that compounded
    bearing error to -23° and drove robot into left guide rail
    - Removed lateral_bias and proportional vy entirely from DRIVE-IN
    - ALIGN k_ang raised 1.0→4.0 so small bearings (~2°) produce enough wz
    to overcome mecanum stiction (was spinning for 26s at wz=0.04)
    - Added solvePnP flip rejection: ty jumps >15cm in one step are discarded
    - Next step: front swivel casters replace mecanum fronts for passive
    guide-rail compliance; Nav2 pre-dock pose for autonomous approach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
    [dock_approach.cpp]
2026-06-29 docking: bearing smoother + dead-band → straight drive-in confirmed
    - 3-sample moving average on solvePnP bearing eliminates noisy corrections
    - 3° dead-band ignores sub-threshold noise entirely
    - Blind zone (0.45m) stops corrections at close range — guide rails take over
    - Eliminated ALIGN phase: pivot-in-place displaces rear swivel caster
    - vx scales 100%→50% inside 0.6m for gentle dock entry
    - diff-drive: AMCL DifferentialMotionModel, EKF vy disabled
    - Result: ±4° bearing, ty < 30mm entire approach, clean stop at 0.26m
    [dock_approach.cpp]
2026-06-29 docking: 60mm tag + ALIGN→SETTLE→DRIVE-IN → dead-centre dock confirmed
    - Switched from 149mm to 60mm AprilTag: stable solvePnP to contact distance,
    no more close-range pose noise causing oscillation
    - Added SETTLE phase (0.25m straight drive after ALIGN) so swivel caster
    self-aligns before bearing corrections begin
    - bearing smoother (3-sample avg) + 3deg dead-band suppress residual noise
    - blind_zone 0.45m: guide rails handle last approach
    - Result: tx=0.260m, ty=-0.002m, bearing=-0.7deg — dead centre
    - Added tag36h11_id1_60mm_A4 PDF/PNG for printing
    [dock_approach.cpp, vision.cpp]
2026-07-05 WIP: IR docking, offline mapping, apriltags, maps, usb-camera-fix
    Bundle uncommitted working tree for cross-machine hub sync:
    - IR docking (dock_ir.cpp + launch), dock_approach/vision tweaks
    - offline mapping + record launches/scripts, saved maps
    - apriltag printables, jupiter-usb-camera-fix systemd script
    - gitignore maps/bags/ (rosbag capture data)
    [dock_approach.cpp, dock_ir.cpp]
2026-07-05 firmware: bring dock_beacon (Nano) + esp32 into jupitercpp_ws/firmware
    Consolidate embedded source into the monorepo so firmware versions with the
    ROS code that consumes it (ESP32 /dock/ir <-> dock_ir.cpp, Nano burst <-> ESP32
    sampler). Drops _V4 dir-copy versioning; git carries history now.
    - firmware/dock_beacon (PlatformIO nanoatmega328, flash from hub via CH340)
    - firmware/esp32 (PlatformIO esp32dev, IR->micro-ROS, flash from Thor)
    - COLCON_IGNORE so colcon skips firmware/; .pio build dirs gitignored
    [encoder.cpp, encoder.h, firmware.ino, imu_bno055.cpp, imu_bno055.h, jupiter_config.h, jupiter_dock_beacon.ino, kinematics.cpp]
2026-07-05 scripts: ir_monitor.py — live /dock/ir monitor + NONE-gap gauge
    Recovered from 2026-07-04 session (was in /tmp, wiped on reboot) and upgraded:
    rolling-window sample rate, per-state %, NONE-gap count + longest gap (ms),
    best-effort QoS, cumulative session summary. Versioned now so it survives reboots.
2026-07-05 micro-ROS: raise serial baud 115200 -> 921600 (fix ~5.7Hz UART bottleneck)
    The 50Hz control-timer callback publishes odom+imu+encoder+/dock/ir every
    cycle (~1.1KB); at 115200 baud (~11.5KB/s) that capped the whole loop at
    ~5.7Hz, throttling odometry/IMU and undersampling the 10Hz IR dock beacon.
    921600 gives ~76Hz of headroom. Firmware Serial.begin + all 9 agent launches.
    (systemd jupiter-microros.service still needs the same change via sudo.)
    [firmware.ino]
2026-07-05 IR dock: burst-packet modulation (Nano) + interrupt edge-detection (ESP32)
    TSOP/VS1838B is a remote-control DATA receiver with AGC that suppressed the old
    90ms near-continuous burst (only onset blips, ~2-9% detection). Switch to the
    modulation these receivers are built for:
    - Nano: 38kHz in packets of 10x 600us bursts + 40ms gap (~19Hz packet rate)
    - ESP32: FALLING-edge ISRs count burst pulses; channel 'detected' if edges seen
    within 80ms. Replaces the 15Hz digitalRead poll (which couldn't catch 600us
    pulses) and decouples detection from publish rate.
    Aim: get the TSOPs we already have to HOLD detection before buying TSSP4038s.
    [firmware.ino, jupiter_dock_beacon.ino]
2026-07-05 hardware: parametric IR receiver shroud (FOV sleeve) for dock docking
    Barrel-only, echoes resulting FOV half-angle. Mount TBD pending module measurements.
    Print black >=2mm wall (IR-opaque), matte bore.
    [ir_receiver_shroud.scad]
2026-07-06 dock_ir: add reverse-approach + rotate-search (params, forward default unchanged)
    - reverse:=true drives backwards (caster-first dock); steer_sign for empirical reverse sign
    - rotate-to-search on beam loss instead of aborting (beam_hold -> search -> give up)
    - fixes latent dead beam-lost branch (latest_ir_ never reset to NONE after 1st beam)
    - docked/stuck detection now gated on driving (no false 'docked' while search-rotating)
    Forward dock behaviour preserved by defaults (reverse=false, steer_sign=1).
    [dock_ir.cpp]
2026-07-06 dock_ir.launch: add reverse:= and steer_sign:= args for reverse-dock testing
2026-07-06 dock_ir: wait-for-IR instead of aborting on brief IR silence (ESP32 reconnect tolerance)
    Was disengaging the instant IR was stale (ir_timeout 1s), which killed the dock if
    engaged before the ESP32 re-attached to a fresh agent, or on a mid-approach micro-ROS
    blip. Now: pause+wait (stay engaged) up to ir_hard_timeout (8s), then give up.
    [dock_ir.cpp]
2026-07-06 esp32: baud 921600 -> 460800 (921600 was unreliable: periodic micro-ROS session drops)
    Stability capture showed clean 15.5Hz when connected, then abrupt session teardown
    ~every 18s = serial-framing corruption at 921600. 460800 doubles timing margin,
    still supports the 15.5Hz payload. Launches/systemd updated once verified stable.
    [firmware.ino]
2026-07-06 dock_ir.launch: expose steer_wz + approach_speed as args for overshoot tuning
2026-07-06 dock_ir: rotate-in-place-to-align mode + clearer logs (show commanded turn direction)
    - rotate_to_align (default true): on LEFT/RIGHT, STOP and rotate in place to re-centre;
    drive straight only on BOTH. Stops burning approach distance while correcting.
    - logs now show sensor + actual commanded turn, e.g. 'IR=RIGHT -> turn LEFT (rotate in place)'
    - exposed as launch arg alongside steer_wz/approach_speed
    [dock_ir.cpp]
2026-07-12 docking: AprilTag-guided two-phase controller with decision-point + go-around
    - dock_range: LiDAR rear-sector wall fit -> /dock/range (distance-only)
    - webcam_publisher: rear USB cam -> /webcam/image_raw for jupiter_vision (80mm tag36h11)
    - dock_ir: APRILTAG_FAR (PD bearing-null, align-then-drive) -> blind rails-final
    with decision-point gates (lateral 6cm via tag, heading 12deg via LiDAR),
    yaw-hold go-around w/ couch guard + attempts limit, tag-blur patience,
    post-dock seat verification off the tag, live-tunable params
    - dock_ir_nodes.launch: full stack minus micro-ROS agent (run agent persistently);
    defaults = proven recipe; monitor scripts under scripts/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
2026-07-12 firmware: 100mm AGV wheel constants, brake-on-zero restored, trims reset, BNO055 rate fix
    - WHEEL_RADIUS 0.0325->0.050, WHEEL_SEPARATION 0.346->0.355 (100mm AGV wheels)
    - motor.cpp: cmd_vel=0 now BRAKES (IN/IN bridge both-HIGH) instead of coasting;
    restores original instant-stop lost in an earlier stop-branch edit
    - trims 0.92/0.93 -> 1.00 (old values tuned for 65mm soft wheels; caused fwd left-bank)
    - imu_bno055: hot path reads only published vectors, OLED reads throttled (12.6->19.9Hz)
    - firmware.ino: publish /dock/ir_rate per-side burst rates; Wire 400kHz
    Note: fwd drives slow-decay (strong), reverse fast-decay (weak at low speed) --
    the reverse-stiction asymmetry root cause; slow-deca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
    [firmware.ino, imu_bno055.cpp, jupiter_config.h, motor.cpp]
2026-07-12 bringup: sensor TF heights +17.5mm for 100mm wheels; CLAUDE.md battery note updated
    - base_laser 0.515->0.5325, ld20_laser 0.13->0.1475 (chassis rose with new wheels)
    - CLAUDE.md: battery divider fitted and verified (stale known-issue removed)
2026-07-13 docking: adopt Nav2 Docking Server (opennav_docking) — closed-loop replacement for dock_ir
    Bespoke controller drove the approach open-loop between corrections; the base's
    asymmetric wheel breakaway made that structurally unable to dock reliably.
    opennav_docking (installed, Jazzy 1.3.12) runs the graceful Park-Kuipers law
    closed-loop on the live AprilTag pose, docks backward natively, has v_linear_min
    for the deadband, and builds in retries/staging.
    - docking_server.yaml: SimpleChargingDock w/ external tag detection, backward
    dock, ice-skate speeds (v_max 0.08); dock DB stub for Nav2 staging later
    - dock_opennav.launch.py: EKF + webcam TF (new, required) + vision + server;
    dock_ir/dock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
    [dock_ir.cpp, docking_server.yaml]
2026-07-18 firmware: dock_charger (Nano) — IR-keyed SSR charge gate, bench-proven
    D2 <- TSOP (38kHz bursts), D5 -> SSR-25DD. Fail-safe rule: ON needs 500ms
    sustained beacon, OFF on 300ms silence (robot-full/undock/fault/power-loss
    all -> dead pins before separation). MIN_EDGES=2 per 100ms window (NEC
    repeat frames are sparse; healthy receiver has ~0 noise edges). Bench test:
    sustained remote press -> LED/SSR ON, release -> OFF. Old receivers were
    dead from a historical short; fresh unit + correct pinout works clean.
    [dock_charger.ino]
2026-07-22 esp32: cmd_vel watchdog + dock proximity sensors + charge-enable IR emitter
    Three-part dock/safety firmware, all bench-verified:
    - cmd_vel WATCHDOG: no cmd_vel for 400ms -> zero targets -> brake. Eliminates
    the latched-command runaway (measured: single pub -> ~450ms spin -> dead).
    - PROX sensors GPIO13/15 (INPUT_PULLUP, NPN): publish /dock/contact bitmask;
    reflex blocks reverse on contact, blocks rotation when seated, forward always
    allowed (undock). Debounced both-sensor 'seated' latch.
    - Charge-enable IR EMITTER: TSAL6400+220R on GPIO4, 38kHz LEDC burst packets
    (FreeRTOS task, core0) gated by seated AND battery<16.70V. Dead-man keepalive
    to the dock Nano/SSR: not-seated -> silenc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
    [firmware.ino, jupiter_config.h]
2026-07-24 Add dock_reflector node: retro-reflective LiDAR dock detection
    Detects the dock's retro-reflective strip on the S2E LiDAR by intensity
    threshold (strip saturates 63; room <=33), segments the largest bright
    cluster, PCA line-fits it, and publishes the dock face pose (centroid +
    outward normal) in base_footprint plus a self-describing debug array
    (along/lateral/range/bearing/skew/strip_len/fit_rms/n_points).
    Replaces the AprilTag approach: gives lateral offset AND face angle from
    one flat strip, survives a moved dock (re-found by its own return each
    cycle). Bench-verified live: range 1.29m, bearing -24.7deg, fit +/-8mm.
    [dock_reflector.cpp]
2026-07-24 Fix base_laser TF z: 0.5325 -> 0.518 (tape-measured)
    S2E scan-plane height re-measured floor-to-lidar = 518mm; the old
    0.5325 was a guess off by ~14.5mm. Mattered for reflector docking:
    a 50mm strip mounted to the guessed height fell off the level scan
    plane with distance (hit at 0.22m, missed entirely at 1.1m). With the
    strip re-centred on the true 518mm, the dock strip saturates full-width
    at pre-dock range.
2026-07-24 Add dock_aligner (Stage A: reverse-in controller)
    Closed-loop reverse into the dock: on /dock/align_start, acquires a
    stable reflector lock, captures IMU yaw, then reverses at 0.05 m/s
    holding that heading (kp_yaw) until both prox seat (/dock/contact==3).
    Reflector skew is NOT used for heading close-in (it balloons below
    ~0.35m as the strip subtends a wide arc); IMU yaw-hold owns heading.
    Optional reflector lateral-centring trim included but default OFF
    (gain 0, sign unverified) for a predictable first test.
    Safety: 20Hz (inside 400ms watchdog), aborts to stop on invalid pose
    >1s / timeout, range floor, low speed caps; firmware seat-reflex is an
    independent backstop. Never moves on launch (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
2026-07-25 firmware: reverse brake-mode + PID anti-windup (fix 13s reverse stall)
    Root cause of the reverse-breakaway stall: the IN/IN H-bridge drove
    FORWARD in fast-decay (dir HIGH, PWM the pwm-pin between drive/BRAKE) but
    REVERSE in slow-decay (dir LOW, PWM the pwm-pin between drive/COAST) =
    electrically weak, so at low duty it couldn't overcome stiction (~13s to
    break away, then lurched). Fix: give each Motor a 2nd LEDC channel so the
    DIR pin can be PWM'd; reverse now mirrors forward (pwm HIGH, PWM the dir
    pin between drive/BRAKE) = fast-decay both directions. Verified wheels-up:
    reverse breakaway 13s -> ~1.3s, correct direction, brake holds.
    Also adds PID anti-windup (conditional integration): the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
    [firmware.ino, jupiter_config.h, motor.cpp, motor.h, pid.cpp]
2026-07-25 firmware: static-friction feed-forward + diff-drive rotation fix
    Feed-forward (MOTOR_FF_STATIC=200): pre-load each wheel toward its
    breakaway PWM in its own commanded direction so both start immediately
    instead of the PID integral crawling up to the stiction threshold. Kills
    the multi-second breakaway lag and the "strong wheel leads -> robot arcs"
    in-place rotation. Wheels-up verified: both wheels move together by
    t~0.25s (was one lagging 0.6-1.5s); L/R mismatch 20% -> 8%.
    Kinematics: diff-drive rotation term (L+W) -> W (half track). The mecanum
    (L+W) over-scaled commanded spin ~1.5x and was inconsistent with the
    getDiffVelocities odometry (which uses wheel_separation).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
    [firmware.ino, jupiter_config.h, kinematics.cpp]
2026-07-25 Breakaway-only feed-forward + aligner stuck-abort; gentle-hold reverse proven
    Firmware: gate the static feed-forward to breakaway-only (fire only when a
    wheel is stalled |rpm|<RELEASE and meaningfully commanded |req|>CMD_MIN),
    so it assists the initial breakaway then steps out and the PID does clean
    fine steering. A continuous FF slammed tiny reverse heading corrections
    and made the robot hunt/over-rotate off the dock.
    dock_aligner: add stuck_abort_s (jammed <seat_zone with no prox + no
    progress -> abort instead of grinding 39s).
    Validated: gentle IMU heading-hold reverse (kp_yaw 0.5, no active reflector
    steering) from a square start runs smooth + arrives centered (lateral
    +0.015m), no osc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
    [firmware.ino, jupiter_config.h]
2026-07-27 firmware: fix getRPM 0.0-return (2.6x speed/odom error) + BNO IMUPLUS + CPR recal
    BIG BUG: Encoder::getRPM() returned 0.0 whenever called more often than
    every 100ms. The control loop runs ~20-26Hz, so most calls got 0.0 —
    telling the PID and odometry the wheel was STALLED while it spun fine.
    Result: PID over-drove to ~loop_rate/10Hz (~2.6x) too fast, and odom
    under-reported distance+yaw by the same factor. Fix: hold and return the
    last computed RPM between 100ms updates instead of 0.0. (Caught because
    the robot drove 2.5m on a 1m command; odom read 1.0m.)
    COUNTS_PER_REV 1372 -> 1290: recalibrated for the 100mm AGV wheels
    (tape-measured), closing the residual ~6% odom error.
    BNO055 NDOF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
    [encoder.cpp, encoder.h, imu_bno055.cpp, jupiter_config.h]
2026-08-01 JetPack 7.2 rebuild + docking: full-bringup fixes, both-prox seat
    Recovery after the SSD crash, reflashed to JetPack 7.2 (L4T R39.2). Build/bringup fixes:
    - jupiter_nodes/CMakeLists: cuda-13.0 -> cuda (version-agnostic symlink for CUDA 13.2)
    - jupiter_bringup/package.xml: drop ldlidar_stl_ros2 exec_depend (LD20 removed)
    - jupiter_bringup_full.launch: display XAUTHORITY uid 2002->2001; gate the dead LD20+cuVSLAM nav behind enable_nav (default false); route TTS to the JetPack-7.2 HDMI PipeWire sink; source ~/microros_ws so the micro-ROS agent is found
    Docking: dock_aligner throat-push + PUSH final-seating state machine; docking_server/dock_opennav tuning; docs (clean-rebuild manifest, docking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
    [funnel_rail_left.stl, funnel_rail_profile.dxf, funnel_rail_right.stl]
2026-08-05 nav: wire SmoothPath into BT, fix yaw tolerance, repair S2E launch
    VALIDATED ON HARDWARE 2026-08-03 (autonomous goals, Lab<->lounge round trip,
    no collisions).
    - navigate_to_pose_omni.xml: call SmoothPath after ComputePathToPose. The
    SimpleSmoother was configured and running but never invoked by the behaviour
    tree, so raw SmacPlanner2D grid paths (diagonal jags every ~5 cm) reached RPP
    directly and made the robot visibly snake. Smoothing them measurably reduced it.
    - nav2_params.yaml: yaw_goal_tolerance 3.14 -> 0.10. At 3.14 (~180 deg) the goal
    checker accepted any final heading, so RPP never performed its final
    rotate-to-heading and the robot stopped facing the wrong way.
    - nav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
2026-08-05 dock_reflector: two-strip detector — stable dock centre and angle to the throat
    PROVEN LIVE 2026-08-05.
    Replaces the single horizontal retro strip (largest-cluster + PCA line fit) with
    two narrow VERTICAL strips (20 x 125 mm) mounted 250 mm apart, centred on the
    pogo centreline. Detection is now: find the two largest clusters, centroid each,
    validate their separation against the known 250 mm baseline, then publish the
    midpoint as the dock centre and the baseline-perpendicular as the dock angle.
    Why: the single strip gave a robust centroid but a FRAGILE angle that ballooned
    below ~0.35 m (a 250 mm strip subtends ~65 deg up close, so the fit returns an
    arc, not a line). That blindness is w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
    [dock_reflector.cpp]
2026-08-05 docs: full status report + Copilot handover brief
    Prepared for a handover of the docking work to GitHub Copilot.
    - docs/JUPITER_FULL_STATUS_2026-08-05.md: complete project status. Every
    subsystem (voice, vision, AI, ROS 2, docking, firmware), every file in the
    workspace with its purpose and dependencies, and the full ROS 2 underlay
    install list with justification for each package.
    - docs/ACTIVE_TASK.md: docking handover brief. Leads with the drivetrain
    measurement that invalidates in-motion steering, then lists what is disproven
    (so it is not re-attempted), what is proven (so it is not rewritten), and what
    is built but untested. Ranked candidate paths, with the mechanical
    wid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
2026-08-08 bench: ESP32 PID converges in 4-9 s — under-gained, not broken
    Re-ran the wheel-tracking bench with a 10 s dwell instead of 3 s. Straight
    reverse only (differential omitted: if authority is restored, az 0.22 held 10 s
    would sweep ~126 deg of arc).
    speed 2-3 s 8-10 s
    0.04 m/s 51 % 88 %
    0.06 m/s 44 % 91 %
    0.08 m/s 43 % 108 %
    0.12 m/s 66 % 98 %
    The 2-3 s column reproduces the earlier bench's 50-70 % exactly -- this is the
    same result with the window extended, not a contradictory one. That measurement
    was correct; reading it as steady state was not. It sampled t = 2-3 s of a 3 s
    step, and with K_I = 5, ~4 RPM error, 20.8 Hz and PWM_MAX = 1023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
    [bench_steer_closedloop.csv, bench_wheel_breakaway.csv, bench_wheel_tracking_long.csv]
2026-08-08 firmware: battery-voltage compensation + record two known velocity-loop issues
    Compiles clean (pio run, esp32dev: RAM 21.2 %, Flash 35.3 %). NOT FLASHED — the
    ESP32 still runs the previous firmware.
    ADDED — battery-voltage compensation:
    Motor torque per PWM count scales with pack voltage, so any tune drifts ~17 %
    between a full pack and the docking range. The robot docks BECAUSE it is low, so
    that is the operating point that matters (Logan's point: testing at full charge
    optimises for a state that never coincides with docking). voltageScale()
    normalises duty to MOTOR_V_NOMINAL = 14.4 V, clamped 0.80-1.25, and returns
    exactly 1.0 on a missing or implausible battery reading so a bad ADC c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
    [firmware.ino, jupiter_config.h]
2026-08-08 spec: fix a bug — the cmd_vel watchdog would brake every position move
    Logan's framing of the Nav2 question (cmd_vel is Nav2's ONLY channel to the
    motors, so a second command path must be checked for impact on that data-flow
    before being added) exposed a real defect in the spec as written.
    moveBase() zeroes the velocity setpoints if no cmd_vel arrives for 400 ms, and
    all-zero velocities take the branch that writes setSpeed(0) = BRAKE. Nothing
    publishes cmd_vel during a position move, so the watchdog would have braked the
    wheels 400 ms into EVERY segment. The spec previously said "existing reflexes
    remain in force, including the cmd_vel watchdog", which would have shipped that
    failure.
    Fi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
2026-08-08 firmware: position-control (segment) mode — /wheel_move
    Compiles clean (esp32dev: RAM 21.2 %, Flash 35.5 %, +1.4 KB).
    NOT FLASHED, NEVER RUN. Treat all behaviour as unverified.
    Docking now commands DISTANCES (encoder counts) instead of speeds. Steering is a
    differential distance -- dS = theta * WHEEL_SEPARATION -- which is geometry and
    does not care how slowly it happens. A slow velocity profile still lands the
    wheels on their target counts, so the turn comes out right. This takes the
    measured 4-9 s velocity-loop settling time off docking's critical path instead
    of fighting it.
    MODE, not an addition. /cmd_vel is the only channel Nav2 has to the motors, so
    position control is mutually exc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
2026-08-10 firmware: position mode WORKS on hardware — add min-speed floor + latched arrival
    FLASHED AND TESTED 2026-08-10, wheels up. First working position-control moves.
    Flashing is now done in place on Thor: esptool v5.3.1 standalone aarch64 binary
    at ~/tools/esptool-linux-aarch64/esptool (no sudo, no system Python -- Thor has
    neither pip nor python3-venv). Full 4 MB restore point saved first at
    ~/firmware_backup/esp32_backup_20260810.bin.
    FIRST TEST found the deadband stall predicted in the spec: a pure proportional
    law decelerates into a crawl the drivetrain cannot execute. At 27 counts
    remaining it asked for 1.6 RPM, the wheels stopped dead, and the stall guard
    correctly fired at 73/100 coun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
    [firmware.ino, jupiter_config.h]
2026-08-10 firmware: calibrate WHEEL_SEPARATION 0.355 -> 0.3586 (measured)
    The old value was a geometric estimate (0.385 out-out minus one 30 mm wheel
    width) and had never been checked against an actual rotation. Since
    theta = (sR - sL)/W, it scaled EVERY commanded angle, the odometry's reported
    angular_z, and Nav2's angular commands.
    METHOD -- rotate in place, compare DELIVERED differential encoder counts against
    BNO055 yaw. Deliberately not commanded-vs-actual, which is polluted by overshoot
    and stalls; delivered-vs-actual isolates the geometry:
    seg diff counts diff mm yaw W
    1 2462 599.6 -95.89 0.3583
    2 2274 553.8 -88.38 0.3590
    3 2663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
    [jupiter_config.h]
2026-08-10 docking: preserve Copilot's V2 work (velocity pursuit) + three-strip detector
    Committed as-is, unmodified, as the record of the velocity-control approach.
    Also fixes a broken tree: CMakeLists.txt already referenced dock_aligner_v2.cpp
    while that file was untracked, so a fresh clone would not build.
    - dock_aligner_v2.cpp: reverse pure-pursuit controller with layered watchdogs
    (capture envelope, reverse envelope, no-progress abort, single-contact abort,
    hard-stop range, seat-push timeout, pose-stale abort, overall timeout).
    Four supervised dock trials, four safe aborts, zero collisions. Carries
    MEASURED seated-pose reference values -- reflector reads range 0.1937 m,
    lateral 0.0039 m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
    [dock_reflector.cpp]
2026-08-10 dock_aligner_v3: segmented position-controlled aligner (NEW, never run)
    Builds clean on Thor. Every behaviour unverified.
    The first aligner that uses the position-control firmware. V1/V2 both steer by
    VELOCITY (Twist -> /cmd_vel), and the measured 4-9 s velocity-loop settling time
    against a ~7 s approach is why every steering correction expired before the
    firmware executed it. V3 commands DISTANCES instead: steering is a differential
    distance (dS = theta * W), which is geometry and does not care how slowly it
    happens, so the velocity lag leaves the critical path entirely.
    NESTED LOOPS -- the whole idea:
    INNER (open): one segment executed by the ESP32 as encoder counts. Precise,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
    [dock_aligner_v3.cpp]
2026-08-10 dock_aligner_v3: fix inverted AIM rotation sign (found by dry run)
    The first dry run caught it before any wheel turned -- which is what dry_run is
    for. Everything else validated: axis_d 0.901 matched the reflector's 0.900,
    offset -0.004, aim +0.8 deg correctly chose DRIVE over AIM, and the straight
    segment computed L=R=-1026 counts for 0.250 m (0.250 * 4106.3 = 1026.6, negative
    = reverse, both wheels equal = straight).
    The AIM sign was backwards:
    dock at lateral -0.018 -> behind and slightly RIGHT, bearing -178.9 deg
    aim = +0.6 deg -> carrot is to the robot's rear-RIGHT
    swinging the rear right requires a CCW body rotation
    firmware kinematics: motor1(L) = vx - wz*W, motor2(R) = vx +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
    [dock_aligner_v3.cpp]
2026-08-10 dock_aligner_v3: ARC segments — first autonomous contact (contact=2)
    Best autonomous docking result to date. Robot reached the seated range within a
    millimetre with one proximity sensor engaged.
    seg 1 ARC 0.250 m +4.0 deg STALL (breakaway from rest)
    seg 2 ARC 0.250 m +4.7 deg DONE
    seg 3 ARC 0.250 m +17.9 deg DONE
    seg 4 ARC 0.096 m -6.8 deg DONE
    seg 5 COMMIT 0.180 m @40rpm -> contact=2
    final: range 0.196 (seated 0.1962), lateral -0.013, skew +2.9 deg
    WHY ARCS. Logan corrected a mistake I had been carrying all session: this chassis
    has ONE rear caster, not two (confirmed in firmware.ino "rear caster config").
    It sits 180 mm behind the drive axle, so an IN-PLACE ro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
    [dock_aligner_v3.cpp, jupiter_config.h]
2026-08-10 dock_aligner_v3: damp the arc loop, add SEAT_NUDGE, log abort reasons
    Approach quality materially improved. First fully clean run -- 0 stalls in 4
    segments, where the previous best was 1 in 4 and in-place pivots were 0 for 3.
    arc_gain 1.0 -> 0.6 and look_min 0.15 -> 0.35 (now a parameter)
    aim oscillation +17.9 -> -18.4 deg became +4.1 -> -5.5 -> +4.1
    final skew +2.9 deg became +0.7 deg
    final lateral -0.013 became -0.008
    range 0.196 (seated 0.1962) both runs -- essentially exact
    The lookahead floor was the important half: at 0.15 m the carrot sits very
    close as the robot closes in, so the same lateral offset pr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
    [dock_aligner_v3.cpp]
2026-08-10 dock_aligner_v3: FIRST FULLY AUTONOMOUS DOCK — contact=3
    seg 1 ARC 0.250 m +2.8 deg DONE
    seg 2 ARC 0.250 m +6.7 deg DONE
    seg 3 ARC 0.146 m -0.6 deg DONE (offset corrected to -0.000)
    seg 4 COMMIT 0.181 m @40rpm -> both prox seated MID-SEGMENT
    state -> SEATED
    final: range 0.196 (seated 0.1962), lateral -0.005, skew -1.4 deg
    Four segments, zero stalls, both proximity sensors. The seat nudge was not even
    needed -- the approach was clean enough that contact=3 landed during the commit
    push. Charging can now start autonomously: contact=3 is what gates the ESP32's
    IR beacon, which closes the dock SSR.
    THE FIX THAT UNBLOCKED IT. The previous run reached contact=2 and then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
    [dock_aligner_v3.cpp]
2026-08-10 firmware: a wheel counts as ARRIVED if it overshoots, not just if it is in band
    Part of the firmware currently flashed on the robot; was left uncommitted.
    Measured on the floor 2026-08-10: a segment travelled its full commanded distance
    and STILL reported STALL. Cause -- the wheels sail slightly past target, remaining
    flips sign, and the loop then commands a small REVERSE correction. MOVE_MIN_RPM
    cannot break stiction from a dead stop under the robot's weight, so it sat there
    until the stall guard fired. Wheels-up this never appeared: no load, no stiction.
    Fix: a wheel is "arrived" if it is inside tolerance OR has overshot (remaining
    flipped sign relative to its target). Never chase a smal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
    [firmware.ino]
2026-08-10 docs: bank the win — docking SOLVED, and correct the caster mechanism
    ACTIVE_TASK.md and the position-control spec both still described docking as not
    working, which would have handed the next session a stale picture.
    - ACTIVE_TASK.md: leads with the successful autonomous dock (contact=3, four
    segments, zero stalls, final range 0.196 / lateral -0.005 / skew -1.4 deg) and
    what made it work, ranked. Explicitly lists what is NOT established: this is
    ONE dock from a good staging pose, repeatability across varied staging is
    untested, cmd_vel override is unverified, the wheels-down IMU acceptance test
    has never been run, and SEAT_NUDGE is written but never executed.
    - Adds a THIRD cor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
2026-08-11 docking: repeatability session — seg_rpm 25, commit-gate fix, back-off retry
    Seven trials with a proper harness (scripts/dock_test_run.sh, CSV per trial).
    Every failure produced a specific fixed cause; last three trials had ZERO stalls.
    T1 12 rpm, cold 3 seg 3 stalls never moved
    T2 16 rpm, warm 4 seg 0 stalls off-centre at seat
    T3 short segs, cold 3 seg 3 stalls never moved
    T4 + escalation 7 seg 3 stalls ran out of segments
    T5 25 rpm 4 seg 0 stalls commit skipped (bug)
    T6 + commit-gate fix 6 seg 0 stalls contact=1
    T7 + back-off retry 5 seg 0 stalls contact=3 PASS
    FINDINGS, in order of how much they mattered:
    1. seg_rpm 12/1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
    [dock_aligner_v3.cpp, jupiter_config.h]
2026-08-11 dock_aligner_v3: POSE control — add the heading term (aim + nyaw)
    V3 was a pure-pursuit controller: it nulled AIM (bearing to the carrot, a
    POSITION error) and never used nyaw (heading vs the dock normal) for control at
    all -- only to locate the axis. Pure pursuit converges position but leaves
    terminal HEADING to fall out of whatever path was taken. Measured 2026-08-11:
    a run reached lateral -0.0007 m -- 0.7 mm off centre, essentially perfect --
    and still carried -2.2 deg of skew. The rear prox sit +-150 mm from centre, so
    2.2 deg puts one ~6 mm out, past an inductive sensor's range. Being centred is
    no use if you arrive crooked. Logan spotted this ("align square with the
    reflector strips"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
    [dock_aligner_v3.cpp, jupiter_config.h]
2026-08-11 docs: archive the 2026-08-11 docking trial record
    Eleven trials with the harness, start pose -> outcome per row. The data behind
    today's findings: the 16-vs-25 rpm breakaway threshold, the commit-gate bug, the
    rails experiment, and the two passes (T7 from 25 mm off-axis, T11 from 295 mm).
    T11 is the reference run: 1.12 m out, 295 mm off-axis, 15.8 deg mis-aimed ->
    contact=3 in 10 segments, final range 0.196 / lateral -0.005 / skew +0.7 deg.
    [dock_trials_2026-08-11.csv]
2026-08-12 firmware: VL53L0X bench — printed mount was reflecting the laser back in
    Adds firmware/i2c_scan, a standalone diagnostic sketch for the front ToF. The
    main firmware cannot print anything (micro-ROS owns the serial port), so the
    I2C/ranging question needed its own binary.
    The finding it produced is the reason to keep it. The three front VL53L0Xs were
    effectively non-functional in their 3D printed casings: ~4% valid readings, values
    uncorrelated with the real target. Out of the mount, changing nothing else, the
    same sensor on the same 3.3 V rail gave 175/175 valid, signal 0.50 -> 22.94 MCPS
    and background 14.20 -> 0.04 MCPS.
    Optical crosstalk. The printed bore returned the VCSEL's own emis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
2026-08-12 docs: design brief for the new ESP32 motion control board (2026)
    Successor spec to "Jupiter ESP32 Drv8870 12vDC ver3_1" (JLCPCB-002, 2024-06-29),
    for redrawing the schematic in EasyEDA and sending to JLCPCB.
    Captures every hardware change since that board was fabricated: 4WD -> 2WD, the
    battery divider on GPIO34, the two dock proximity sensors, the dock IR emitter,
    and the I2C expansion to a TCA9548A mux plus up to 7 VL53L0X.
    Pin map is taken from firmware/esp32/include/jupiter_config.h rather than the old
    schematic, since the firmware is what the robot actually runs.
    Three contradictions are flagged for bench resolution BEFORE anything is drawn:
    - DRV8870 VM shows +12 V on ver3_1, but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
2026-08-12 docs: board brief — buck-then-linear power, not a 3.3 V buck
    Revises §10. The DevKit is fed 5 V into VIN and regulates its own 3.3 V, so both
    ver3_1 rails are stressed, not just the 3.3 V one. A single buck to 5 V feeding
    the RETAINED SSP1117-3.3 is simpler than two switchers and keeps the 3.3 V rail
    linear — which matters because that rail feeds the ToF array and sits beside the
    12-bit pack-voltage ADC. LDO dissipation falls to ~0.7 W, fine in SOT-223.
    Adds the component list (MP1584EN / AP63205, inductor, caps, feedback divider),
    switcher layout rules, and a note that the inductor and freq-set values are a
    starting point to confirm against the datasheet rather than a verified design.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
2026-08-12 docs: board brief — bring the 16.8→12 V buck onboard, three rails
    The board is currently fed 12 V by an external 16.8→12 V buck elsewhere on the
    robot. New design takes the raw 4S pack and makes all three rails itself:
    PACK -> fuse -> ideal diode -> BUCK 12 V (5 A) -> DRV8870 VM, prox
    -> BUCK 5 V (2 A) -> DevKit, IR
    -> SSP1117-3.3 -> sensors
    Two switchers, one linear. 5 V derives from 12 V so only one stage sees pack
    voltage. The 3.3 V rail stays linear on purpose — it feeds the ToF array and sits
    beside the pack-voltage ADC, and neither wants switching ripple.
    Resolves §9.1: VM is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
2026-08-13 firmware: publish the front ToF as sensor_msgs/Range on /tof/front
    Brings the single VL53L0X into the micro-ROS feed — the low near-field obstacle
    layer the LiDAR cannot see, since it scans well above floor level.
    Verified live: range 0.9954 m against a laser-measured 0.998 m, so 2.6 mm out at
    a metre. The bench calibration transferred directly.
    Three things the integration is careful about:
    - A MISSING SENSOR CANNOT BREAK THE ROBOT. tof_present latches once at boot; if
    the VL53L0X is absent or will not configure, the publisher is never created
    and every ToF path is skipped. Motors, odometry and prox are unaffected.
    - READS NEVER BLOCK. readRangeContinuousMillimeters() polls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
    [firmware.ino, jupiter_config.h, main.cpp]
2026-08-13 bringup: static TF base_footprint -> tof_front_link
    Places the front VL53L0X in the TF tree so /tof/front can be consumed downstream.
    Measured 2026-08-13: 165 mm forward, on centreline, 85 mm above the floor, tilted
    8 deg nose-up. Pitch is NEGATIVE for up, matching the camera's -0.0995 convention.
    Added to navigation_s2e.launch.py because that is the live nav path (AMCL, S2E at
    0.518 m). Deliberately NOT added to navigation.launch.py, which is stale: cuVSLAM,
    the old c82_map_real map, and a base_laser TF still describing the LD20 that was
    physically removed on 2026-08-03.
    The 8 deg tilt is recorded but UNVERIFIED. Every attempt to check it against a real
    floor was defeated by the printed c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
2026-08-13 bringup: one canonical full launch — repoint bringup_full at navigation_s2e
    jupiter_bringup_full.launch.py still included navigation.launch.py, the retired
    stack: cuVSLAM instead of AMCL, the old c82_map_real map, and a base_laser TF
    390 mm too low with the yaw 180 deg out — describing the LD20 physically removed
    on 2026-08-03. It had been papered over by defaulting enable_nav to false, so the
    "full" bringup quietly started the robot with no navigation at all.
    Repointed at navigation_s2e.launch.py and enable_nav now defaults to true.
    A naive swap would have broken two things, because navigation_s2e starts the
    micro-ROS agent AND the Orbbec camera itself:
    - two Orbbec nodes on one ser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
2026-08-13 bringup: header — mark bringup_full as the one canonical full launch
2026-08-13 docs: CLAUDE.md — point at the one surviving bringup
    The master-launch line still named jupiter_bringup.launch.py, deleted in 227742e.
    Records that bringup_full is the single full-stack launch, that navigation_s2e
    supplies camera/agent/TFs beneath it, that mapping lives in slam_mapping_s2e, and
    adds the front ToF to the subsystem list.
2026-08-13 bringup: delete the LD20-era offline mapping pipeline and camera_ai
    Removes the bag-record -> offline-map workflow built around the LD20, which was
    physically removed 2026-08-03. The three launches cross-referenced each other and
    a runner script, so they go as a set:
    record_mapping.launch.py bag recording
    offline_mapping.launch.py bag -> map
    offline_mapping_deskew.launch.py bag -> map with scan deskew; carried a
    base_footprint->base_laser TF at z=0.13, the
    old LD20 height (S2E scans at 0.518)
    record_mapping_run.sh runner for the above
    camera_ai.launch.py unreferenced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
2026-08-13 nav: wire the front ToF into the costmap; refresh CLAUDE.md to current build
    RangeSensorLayer on the LOCAL costmap consuming /tof/front, replacing the dead
    scan_low ObstacleLayer source (the LD20 went 2026-08-03 and /scan_low has not
    published since). Removed scan_low from both local and global costmaps.
    CORRECTS AN EARLIER MISTAKE IN THIS BUILD: the firmware published +Inf for "nothing
    detected" per REP-117, which is wrong for this consumer. RangeSensorLayer's
    processVariableRangeMsg discards any reading above max_range before it can act, so
    +Inf meant the cone would mark an obstacle once and NEVER clear it. Firmware now
    publishes exactly max_range, which is what clear_on_max_reading keys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
    [firmware.ino]
2026-08-14 dock_reflector: strip baseline 250mm -> 205mm for the re-made dock strips
    The dock's outer reflector strips were re-made in the same material as the centre
    strip and repositioned to sit vertically above the robot's rear prox sensors.
    Measured centre-to-centre is now 205 mm (strips 20 mm wide), not 250 mm.
    This was NOT a benign mismatch. At 205 mm against a 250 mm expectation the triplet
    still falls inside baseline_tol (200-300 mm) and is ACCEPTED, but the confidence
    separation term collapses:
    sep_score = 1 - (45mm / 50mm) = 0.10
    which drags total confidence below dock_aligner_v3's min_confidence 0.70 gate. The
    aligner would have refused to acquire and reported "no usable dock lock —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
2026-08-14 dock_aligner_v3: correct the prox spacing from an estimated 300mm to 205mm
    The back-off-retry rationale reasoned about skew using a "~300 mm prox spacing"
    that was an estimate. Logan measured the rear prox sensors at 205 mm centre-to-
    centre (the dock's outer reflector strips are now aligned vertically above them).
    The correction runs in the ROBOT'S FAVOUR, which is worth stating because the
    original note implied the opposite. Corner offset for a given skew scales with the
    spacing, so a narrower spacing tolerates MORE skew:
    max tolerable skew = atan(8mm / 205mm) = 2.23 deg
    at the assumed 300mm it would have been 1.53 deg
    So the reference failure at 2.2 deg of skew was sitting rig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
    [dock_aligner_v3.cpp]
2026-08-14 dock_reflector: strip baseline is 210mm (measured), not 205mm
    205 mm is the REAR PROX SENSOR spacing; 210 mm is the dock STRIP spacing. Two
    different measurements that got conflated in the first pass. The outer strips sit
    approximately, not exactly, above the prox sensors — 2.5 mm wider per side.
    Confirmed two independent ways with the robot seated at contact=3:
    - tape: 210 mm centre-to-centre
    - detector: 210-211 mm from its own cluster centroids
    (left -102.8, centre +2.1, right +107.5 mm lateral)
    centre strip 0.25 mm off the midpoint of the outer pair
    Measured effect on the confidence the aligner gates against:
    baseline_expected 0.250 (stale) -> s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
2026-08-18 docs: motion control board brief is no longer ESP32-specific
    Renames NEW_ESP32_MOTION_CONTROL_BOARD_2026.md -> NEW_MOTION_CONTROL_BOARD_2026.md
    and adds §2 "MCU and IMU — the open platform decision". The MCU is deliberately
    NOT fixed: the stated objective (reduce chassis wiring) is delivered by the PCB
    layout, not by the choice of microcontroller, so §4-§11 proceed regardless.
    MCU candidates recorded with the honest trade:
    - ESP32-S3 as the low-risk modernisation. Retires the 2016-era WROOM-32 AND the
    CP2102, which is not cosmetic: the parking lot records an unpowered CP2102
    holding EN through Thor's cold boot, floating the motor inputs into a
    continuous wheel spin. Nativ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
2026-08-18 docs: RP2350 micro-ROS gate CHECKED — not cleared
    Verified rather than assumed. The official micro-ROS/micro_ros_raspberrypi_pico_sdk
    is titled "Raspberry Pi Pico (RP2040) and micro-ROS integration" and mentions no
    RP2350, Pico 2 or PICO_PLATFORM. The precompiled libmicroros.a targets Cortex-M0+
    (ARMv6-M, soft-float); RP2350 is Cortex-M33 (ARMv8-M, hard-float). Using it means
    rebuilding micro-ROS against a cortex-m33 toolchain with a matching float ABI —
    achievable, but a project in itself and unproven on this target.
    Also records that most published RP2350 + micro-ROS enthusiasm compares against
    the RP2040, not an ESP32, and those advantages do not survive contact with this
    firmware: S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
2026-08-18 docs: board brief — BNO086 decided, OLED deleted, current sensing added
    Folds in the 2026-08-19 design session.
    IMU — DECIDED: BNO086, magnetometer fitted but NOT trusted by default. The
    justification is off-map operation, not the usual spec comparison, and both halves
    are recorded because they point opposite ways:
    - Indoors the magnetometer is unusable regardless of chip. Hard/soft-iron
    calibration corrects distortion fixed to the SENSOR; rebar is fixed to the
    BUILDING, so it varies with position and no calibration tracks it. Indoors the
    absolute reference is the map (AMCL) plus the dock, where contact=3 is a known
    pose to millimetres — a better heading re-zero tha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
2026-08-18 docs: S3 pin map, PCNT correction, and IMU placement guidance
    Adds §3.1 — a proposed ESP32-S3 pin map for the 2-driver board with BNO086 and no
    OLED. 23 pins, analog confined to ADC1 (GPIO1-10) since ADC2 dies with WiFi,
    strapping/USB/flash pins left alone, and GPIO33-37 flagged as spare ONLY on
    non-octal-PSRAM modules. Motor drive pins carry mandatory 10k pull-downs — the
    floating-input cold-boot wheel spin is on record and pin numbers do not change
    that.
    Notes that the INA226 measures bus voltage as well as current, so it deletes the
    battery divider, its filter cap, an ADC channel, the ESP32 ADC non-linearity and
    esp_adc_cal — and retires §10.2, since the divider resistor uncertai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
2026-08-18 docs: add §3.2 module support circuitry — the gap left by dropping the DevKit
    ver3_1 socketed an ESP32 DevKit, so the board never had to provide USB, reset,
    boot or module decoupling. Soldering a bare WROOM-1 down makes the PCB the carrier,
    and none of that circuitry was specified anywhere in this document.
    Adds: module decoupling, EN RC power-on reset, BOOT button, USB-C receptacle wired
    to GPIO19/20 with the 5.1k CC pull-downs (without which the host never enumerates),
    and USB ESD protection. Notes that the auto-reset transistor pair is NOT needed —
    USB-Serial-JTAG does reset and download mode natively, which is one more job the
    CP2102 existed to do.
    Flags the USB power question as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
2026-08-18 docs: §3.2 becomes a complete bare-module build list
    Logan has decided to go with a bare WROOM-1 rather than a socketed DevKit,
    deliberately, for production-PCB experience. ver3_1 socketed a DevKit so the board
    never provided any of the support circuitry; this section is now the full list of
    what has to be added, grouped and costed at roughly 15 parts.
    Group 1 - module essentials: 100nF at the pin, 22uF bulk for WiFi TX bursts,
    10k + 1uF EN RC power-on reset
    Group 2 - boot/reset: EN and GPIO0 buttons, GPIO0 pull-up
    Group 3 - USB-C: receptacle, USBLC6-2SC6 ESD, and the 5.1k CC1/CC2 pull-downs
    that are the single most common first-board USB bug
    Group 4 - USB v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
2026-08-18 docs: MCU mounting DECIDED — socketed DevKit, bare-module list retained
    Logan reviewed the bare-module effort and chose to socket an ESP32-S3-DevKitC-1
    into female headers, as ver3_1 does today. §3.2 now records that decision; the full
    bare-module parts list is kept as §3.2b rather than deleted, since it is the harder
    path to reconstruct and a later revision may take it once the analogue side and the
    mux are proven.
    Nothing that matters is lost: every wiring win is independent of how the MCU is
    mounted, and USB-Serial-JTAG debugging still works because the DevKitC-1 carries two
    USB-C ports — native USB and the UART bridge. What is given up is structural
    deletion of the bridge chip, so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
2026-08-18 docs: MCU and battery monitoring both settled
    MCU DECIDED: ESP32-S3-DevKitC-1, socketed, N16R8 accepted. RP2350 was reconsidered
    and rejected on measurement rather than preference — the Pico 2 exposes only 26 of
    the RP2350's 30 GPIO (GP23/24/25/29 never reach the header), giving 2 spare against
    the S3 DevKit's 6, and just 3 ADC channels against the S3's ten on ADC1. It is
    worse on pins, not better. "Only the micro-ROS risk" also understated it: the
    firmware rewrite is the dominant cost, and the off-CPU encoder gain is already
    matched by the S3's PCNT. RP2350 is dominated here.
    BATTERY MONITORING DECIDED: the resistive divider is DELETED. An INA226 supplies
    bus voltage and current over I2C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
2026-08-18 docs: ToF DECIDED — stay with VL53L0X, geometry fix not a new part
    Logan already holds 8 VL53L0X from the earlier ring BOM. VL53L5CX multizone was
    raised in this session and is NOT warranted: the measured blind wedge is a mount
    geometry problem, and the fix is free because the mounts must be reprinted anyway
    for the crosstalk issue.
    Modelled across mount height and tilt using (H - h)/tan(12.5 - tilt):
    85mm / 8deg (as built) : 30mm object blind inside 0.70 m — useless, and exactly
    what was measured on 2026-08-14
    50mm / 8deg (adopt) : 30mm object blind inside only 0.25 m, 50mm object
    always visible, floor does not enter the con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
2026-08-18 docs: pin map verified against the real DevKitC-1 pinout, header mapping added
    Logan supplied the ESP32-S3-DevKitC-1 pinout diagram. The §3.1 assignment is
    confirmed valid on an N16R8, and is now recorded mapped to the physical headers so
    it can be worked from directly at layout.
    Confirmed from the diagram:
    - ADC1 is GPIO1-10 (CH0->CH9) as assumed; ADC2 sits on GPIO11-20 and is dead
    with WiFi, so those pins are correctly used for digital only
    - the IMU SPI assignment lands on the native FSPI IO_MUX pins (FSPICS0=10,
    FSPID=11, FSPICLK=12, FSPIQ=13) rather than routing via the GPIO matrix
    - GPIO35/36/37 ARE broken out but carry SPIIO6/SPIIO7/SPIDQS, the octal PSRAM
    signals,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
2026-08-18 docs: add resistor summary and the three gotchas to the pin map
    Full 44-pin connection table worked through, yielding a schematic checklist:
    5x 10k pull-DOWN (4 motor drive pins + IR MOSFET gate), 3x 10k pull-UP (IMU_CS,
    IMU_RST, MUX_RST — all active-low or must idle deasserted), 2x 4.7k pull-UP (prox,
    so the level does not depend on firmware INPUT_PULLUP), 2x 2.2k pull-UP (I2C at
    400 kHz), plus ISENSE RC filters and the prox protection network.
    Records the three that bite: the DevKit's two 3V3 header pins must NOT be connected
    (they are LDO output — tying them to the board rail puts two regulators in
    contention; feed 5V and share GND only, as ver3_1 does); the five pull-downs are
    safet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
2026-08-18 docs: §3.3 complete interconnect — every net, both ends
    Logan pointed out that §3.1/§3.2 gave a pin inventory and a BOM, not a wiring
    table — he asked what each pin connects to at the far end, including the mux/ToF
    fan-out. Fair, and this section is the schematic in table form.
    Covers the 44 DevKit pins with destination device AND destination pin, plus the
    sections that never touch the MCU: DRV8870 x2 (including ISEN feeding both the
    200 mOhm sense resistor and the current-sense amp), CN1/CN2 motor+encoder pinout,
    BNO086 SPI wiring with PS0/PS1 both high to select SPI, TCA9548A with explicit
    ToF channel assignment (front L/C/R, rear L/R, side L/R, one spare) and the 14
    per-channel pu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
2026-08-19 docs: CORRECT pin map against official DevKitC-1 pinout — RGB is on GPIO38
    Logan supplied Espressif's official ESP32-S3-DevKitC-1 pinout. It shows the onboard
    RGB LED on GPIO38 (silkscreen reads RGB@IO38), not GPIO48 as earlier drafts assumed.
    §3.1 had M1_DIR on GPIO38, which would have put a motor direction line on the LED
    driver's net. Corrected:
    STATUS_LED 48 -> 38 (onboard RGB; neopixelWrite(), not digitalWrite())
    M1_DIR 38 -> 48 (SPICLK_N is an alternate function only, free as GPIO)
    M2_ENC_B stays on GPIO5. Everything else in the map is confirmed correct against the
    official diagram: ADC1 is GPIO1-10, ADC2 occupies 11-20 and is dead with WiFi, the
    IMU SPI lands on the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
2026-08-20 docs: standalone ESP32-S3 pinout reference for schematic capture
    Logan asked for the 44-pin table as its own file to work from in EasyEDA rather
    than scrolling chat history. Physical header order, matching the Espressif
    DevKitC-1 diagram.
    One row changed from the version he pasted: GPIO4 is no longer spare. The battery
    voltage divider moved onto the MCB — VCC is already there as the buck input, so
    tapping it locally deletes R1/R2 from the power perf board AND removes a chassis
    wire, which was the whole objective. GPIO9 is now the only spare pin.
    Also drops the INA226 from GPIO16/17. Not being fitted: it would mean another
    off-board module, a 5 mOhm shunt spliced into the 40 A pack line,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
2026-09-28 docs: §11 regen protection DRAWN — record the two deviations
    D8 (SMBJ15A) + C39 (470uF/35V) are now on the motor controller sheet.
    Two things §11 got wrong that the build exposed:
    1. Symbol: every Device:D_TVS* in KiCad is BIDIRECTIONAL (pins A1/A2) —
    i.e. the SMBJ15CA this very section warns against. Unidirectional TVS
    is drawn as Device:D_Zener, pin 1 = K. Recorded so the next person
    does not pick the symbol whose name matches.
    2. "Near the drivers" held for the TVS (10 mm) but was impossible for the
    bulk cap. With all 141 footprints placed, the nearest free 10x10.5 mm
    spot is 46 mm away; even an 8 mm can gets no closer than 44.5 mm.
    Documented why that is accepta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
2026-09-28 docs: §11 — D8 was drawn backwards; check polarity from the netlist
    Records the near-miss: the TVS was drawn cathode-to-GND, which would have
    shorted the 12 V rail at ~0.7 V on first power-up. It rendered correctly on
    the canvas — a rotated symbol can look right and net up reversed, because
    the schematic file stores Y downward while the symbol library stores it
    upward.
    Adds the rule (verify orientation from the netlist, not the drawing) and
    the grep that does it, for both D8 and C39.
2026-09-28 docs: §11 bulk cap settled — KNSCHA KAT1V471M10100PDT, LCSC C55348734
    470 uF 35 V, SMD can D10 x L10.5 mm, so the size the placement was planned
    around held and C39 did not have to move.
    Also records the placed board positions (D8 at 10 mm from the VM pins,
    C39 at 60.5/39.5) and that both polarities were confirmed from the
    netlist rather than the drawing.
2026-09-29 docs: ESP32-S3 pinout stub redirect + 2026 schematic PDF
    Logan's own uncommitted work, committed on request — it predates this
    session and has been sitting in the working tree since the JetPack 7.2
    rebuild left the tree with drift.
    ESP32_S3_MCU_JUPITER_PINOUT.md reduced to a stub pointing at
    NEW_MOTION_CONTROL_BOARD_2026.md §3.1, which became the single source of
    truth for the 2026 board on 2026-08-24. The old DevKitC-1 table it carried
    is superseded — that board is now a soldered WROOM-1U-N16 module.
    Adds Jupiter_ESP32_S3__2026_Final.pdf, the 1-page schematic sheet.
